squishy-scsi/hardware/README.md

# Squishy - Hardware

This repository contains the hardware design files for [Squishy](https://github.com/squishy-scsi/squishy).

You can view a live rendering of the WIP hardware in your web browser [here](https://kicanvas.org/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), thanks to [KiCanvas](https://kicanvas.org/).

> [!IMPORTANT]
> If you're looking for the Squishy software/gateware, they can be found at [`squishy-scsi/squishy`](https://github.com/squishy-scsi/squishy).

## Documentation

The documentation for the Squishy hardware can be found [here](https://docs.scsi.moe/hardware/index.html).

## License

The hardware design files for Squishy are licensed under the [CERN-OHL-S](https://ohwr.org/cern_ohl_s_v2.txt), the license for which can be found in [LICENSE](./LICENSE)
