squishy-scsi/hardware/contrib/hardware-plans.md

# Squishy - rev2 hardware plan

The following are the planned design requirements for rev2 of the hardware, as well as some wishlist items

## Requirements

- [ ] Allow for both HVD and LVD
- [ ] Single Ended support
- [x] Termpower detection
 - [x] Fix termpower enable, seems to be enabled on powerup,
- [ ] Length-Match the inputs to the SCSI-Phy
- [x] Button for rebooting into bootloader for DFU
- [x] Upgrade FPGA
  - [x] ECP5? - LFE5UM5G-45F-8BG381C
- [ ] >= USB 3.2 Gen1

## Wishlist Items

- [x] USB-C Connector
- [ ] Support for bus arbitration and multi-host bus'

## TODO List:

 - [ ] Removed half of the sys LEDS
 - [ ] Route the ULPI PHY
 - [ ] Route the SuperSpeed lines
 - [ ] Route the SPI Flash
 - [ ] Route the Supervisor connection to the FPGA
 - [ ]

# Squishy - rev3

The following are the planned design requirements for rev3 of the hardware, as well as some wishlist items

## Requirements

## Wishlist Items
