squishy-scsi/hardware/release/rev1/gerbers/squishy-drl_map.dxf

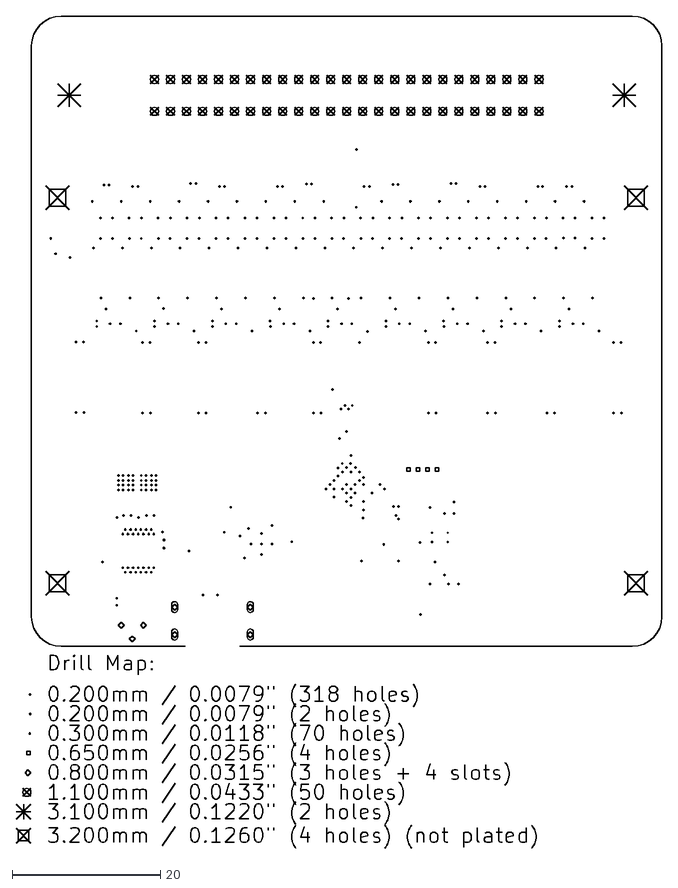
[picture p1: CAD file, 2021-09-27]
release/rev1/gerbers/squishy-drl_map.dxf
87.1 x 112.2
