squishy-scsi/hardware/release/rev2-evt/connector-modules/errata.md

# Squishy rev2-connector-evt Errata

## All

* [ ] Thermal reliefs on all through-hole pins connected to plane layers, especially GND
* [ ] I2C Write-Protect is hard-wired to GND, oops, can't write to any of them,

## HVD-50-CE

## HVD-50-HD

## HVD-50-IDC

## HVD-68-HD

## HVD-68-VHDCI

## MSE-50-CE

## MSE-50-HD

## MSE-50-IDC

## MSE-68-HD

## MSE-68-VHDCI
