squishy-scsi/hardware/boards/squishy/connector-modules/TODO.md

# Connector Modules TODO

- [X] hvd-50-ce
  - [X] Routed
  - [X] Length-Matched
  - [X] ERC
  - [X] DRC
  - [X] CAM Files
  - [X] BOM
- [X] hvd-50-hd
  - [X] Routed
  - [X] Length-Matched
  - [X] ERC
  - [X] DRC
  - [X] CAM Files
  - [X] BOM
- [X] hvd-50-idc
  - [X] Routed
  - [X] Length-Matched
  - [X] ERC
  - [X] DRC
  - [X] CAM Files
  - [X] BOM
- [X] hvd-68-hd
  - [X] Routed
  - [X] Length-Matched
  - [X] ERC
  - [X] DRC
  - [X] CAM Files
  - [X] BOM
- [X] hvd-68-vhdci
  - [X] Routed
  - [X] Length-Matched
  - [X] ERC
  - [X] DRC
  - [X] CAM Files
  - [X] BOM
- [X] mse-50-ce
  - [X] Routed
  - [X] Length-Matched
  - [X] ERC
  - [X] DRC
  - [X] CAM Files
  - [X] BOM
- [X] mse-50-hd
  - [X] Routed
  - [X] Length-Matched
  - [X] ERC
  - [X] DRC
  - [X] CAM Files
  - [X] BOM
- [X] mse-50-idc
  - [X] Routed
  - [X] Length-Matched
  - [X] ERC
  - [X] DRC
  - [X] CAM Files
  - [X] BOM
- [X] mse-68-hd
  - [X] Routed
  - [X] Length-Matched
  - [X] ERC
  - [X] DRC
  - [X] CAM Files
  - [X] BOM
- [X] mse-68-vhdci
  - [X] Routed
  - [X] Length-Matched
  - [X] ERC
  - [X] DRC
  - [X] CAM Files
  - [X] BOM
