squishy-scsi/hardware/(threads)

Thread 13 (2022-06-28):

Complete rev2 FPGA Supervisor layout

lethalbit, 2022-06-28:
The layout for the FPGA supervisor mcu needs to be completed.

- [x] Connect SPI bus + control signals to FPGA
- [x] Connect SPI bus to onboard flash
- [x] Connect LEDs
- [x] Connect to DFU trigger button

Closed 2024-06-14.

Thread 2 (2022-06-28):

micro SD Card SPI/SDIO Support

lethalbit, 2022-06-28:
The rev2 hardware has an on-board micro SD Card slot for storage emulation or other possible features, ideally the communication would be over SDIO if possible, but fallback to SPI mode for the SD Card might be needed.

Closed 2024-06-14.

Thread 6 (2022-06-28):

Layout rev2 tempwr ADC and switching

lethalbit, 2022-06-28:
The rev2 hardware has a current/voltage ADC to measure TERMPWR to try to detect if the hardware has a fault.

This ADC as well as the TERMPWR enable/disable circuitry needs to be laid out and hooked up.

Closed 2024-06-14.

Thread 7 (2022-06-28):

Route the rev2 external trigger and refclk

lethalbit, 2022-06-28:
The rev2 hardware has support for an external trigger and refclk to assist in the analysis and capture of SCSI traffic.

The two SMA connectors on the left edge of the rev2 board need to be routed and length matched.

lethalbit, 2024-06-14:
External Trigger has been done, refclock has not been implemented, maybe on rev3

Closed 2024-06-14.

Thread 9 (2022-06-28):

Design rev2 Physical bus interfaces

lethalbit, 2022-06-28:
The rev2 hardware is designed to have an interchangable bus / device front-end based on using the Samtec QTH-060-01-X-D-RA-PGP as it's connector.

Ideally we will have a board for each of the following SCSI connectors, more than one per board is okay, in the case of the IDC connectors and other small connectors.

- [ ] HD50
- [ ] DB25
- [ ] HD68
- [ ] C50
- [ ] IDC50
- [ ] IDC68
- [ ] SCA80
- [ ] VHDCI
- [ ] MD50
- [ ] MD68

Thread 16 (2024-12-01):

BOM Line consolidation / DFM Optimization

lethalbit, 2024-12-01:
Currently for rev2, and it's supporting boards there is a bit of a chunky BOM, and while some items are shared between the connector boards, the PHYs and the main board, it could be improved.

The following things could vastly simplify the BOM at the cost of ease of assembly:

* [ ] Standardize to smallest package size where possible
  * This would mean that all passives would be `0201` or `0402` where possible
* [ ] Normalize derating for capacitors
  * The capacitors on the board have been derated by at least 150%, which might be overkill but results in larger packages, which also leads into the first item

Those are the first two things that come to mind, there are also some DFM optimizations that would need to be made to make assembly easier, that ties into the BOM consolidation, but there are some other things as well:

* [ ] Remove as many THT parts as possible to remove as much manual assembly as possible
  * Currently there are only 2(?) parts that are through hole, the DC jack and the rest button, we could possibly swap the reset button to an SMD variant and normalize it with the DFU trigger button, which also eliminates a BOM line item.
* [ ] Ensure all ground connections for through-hole parts have thermal spokes
  * Due to the main board being 8-layers and having very substantial ground planes, trying to solder any leads that are connected to ground just soak up heat making it hard to solder.

The following other misc items are also tied in but don't fall exactly in line with DFM, if we want to have a case, it would be cheaper to go for a standard extruded aluminum shell, but this limits our ability to do module stacking like planned, meaning you need to pull the device out of the case to swap things like PHYs or connectors, which is a big downside, but on the upside it would mean you don't need custom milled cases for each part.

We could also possibly squish the board a big to make it less long, compress the power supply area a bit to save board space.

Also possibly rotating the design a bit to have a more standard flow-through so the USB and power connectors are on the bottom rather than side, we would also need to rotate the FPGA anyway if we keep using the ECP5 so we can use the high-speed IO on the SCSI PHY connector.

Thoughts/additions @dragonmux, @esden?

Thread 17 (2025-01-23):

Supervisor/FPGA/PSRAM SPI bus CIPO line loading is environmentally/climate dependant

lethalbit, 2025-01-23:
The `FPGA_CIPO` line from the SPI bus that is between the FPGA, Supervisor, and PSRAM, seems to not be loaded enough in warm and dry conditions.

Probing the bus for debug, or briefly touching a x10 oscilloscope probe to the test point resolves this by adding just a handful of pF enough to cause the bus to come back.

This is only a problem when trying to talk to the PSRAM under a memory read condition before the FPGA is up, if you only read the ID, then it's fine.

This also for some reason does not affect programing the FPGA over the same bus, unsure why.
