squishy-scsi/hardware/release/rev1/squishy.pdf

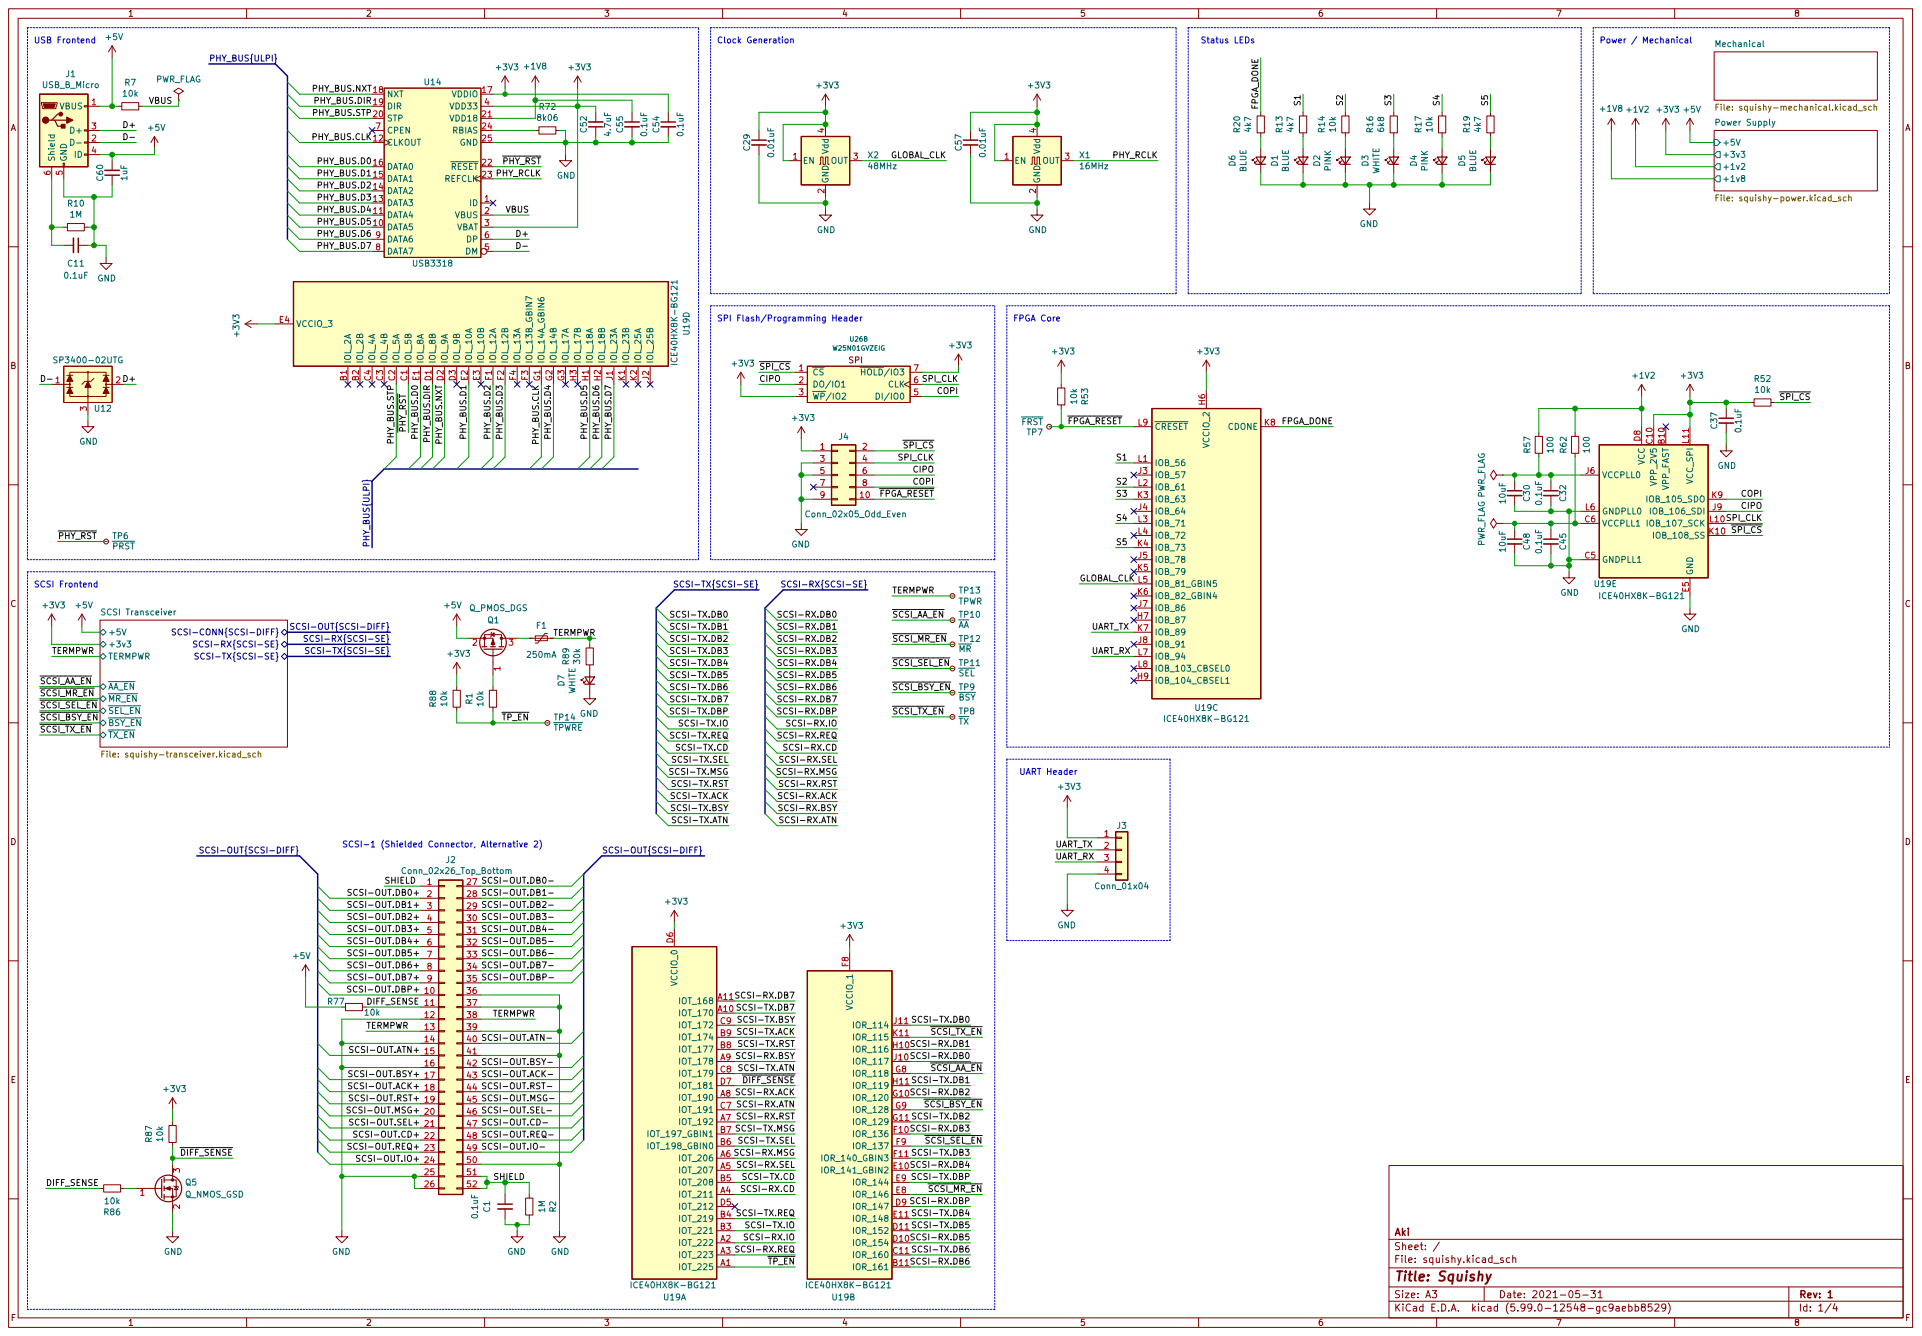
[picture p2: page 1]

FPGA Core USB Frontend

Power / Mechanical SCSI Frontend

Mechanical File: squishy-mechanical.kicad_sch +5V

SCSI-RX.ATN PHY_BUS.D7 TERMPWR

SCSI-RX{SCSI-SE}

SCSI-TX.DB4 SCSI-TX.DB1 SCSI-TX{SCSI-SE} SCSI-TX.DB0 SCSI-OUT.REQ+

TERMPWR
SCSI-RX.DB7 SCSI-RX.DB5 SCSI-RX.BSY
SCSI-RX.RST SCSI-RX.DB7 SCSI-TX.SEL ~{TP_EN}

~{TP_EN} SCSI-OUT.DBP- TERMPWR

SCSI-CONN{SCSI-DIFF} TERMPWR

SCSI-TX{SCSI-SE}

SCSI-TX.DB7
SCSI-TX.DB1 SCSI-TX.DBP
SCSI-TX.IO
SCSI-TX.REQ

SCSI-RX.DBP
SCSI-RX.IO
SCSI-RX.REQ
SCSI-RX.CD
SCSI-RX.SEL SCSI-RX.ACK
SCSI-RX.MSG

SCSI-1 (Shielded Connector, Alternative 2)

SCSI-OUT.DB1- SCSI-OUT.SEL+ SHIELD

SCSI-RX.DB4 ~{SCSI_MR_EN} SCSI-TX.BSY
~{DIFF_SENSE} SCSI-TX.ACK
SCSI-TX.RST

SCSI-RX.RST SCSI-RX.MSG
SCSI-TX.MSG

SCSI-TX.DB4 SCSI-TX.DBP

File: squishy.kicad_sch Sheet: / Aki

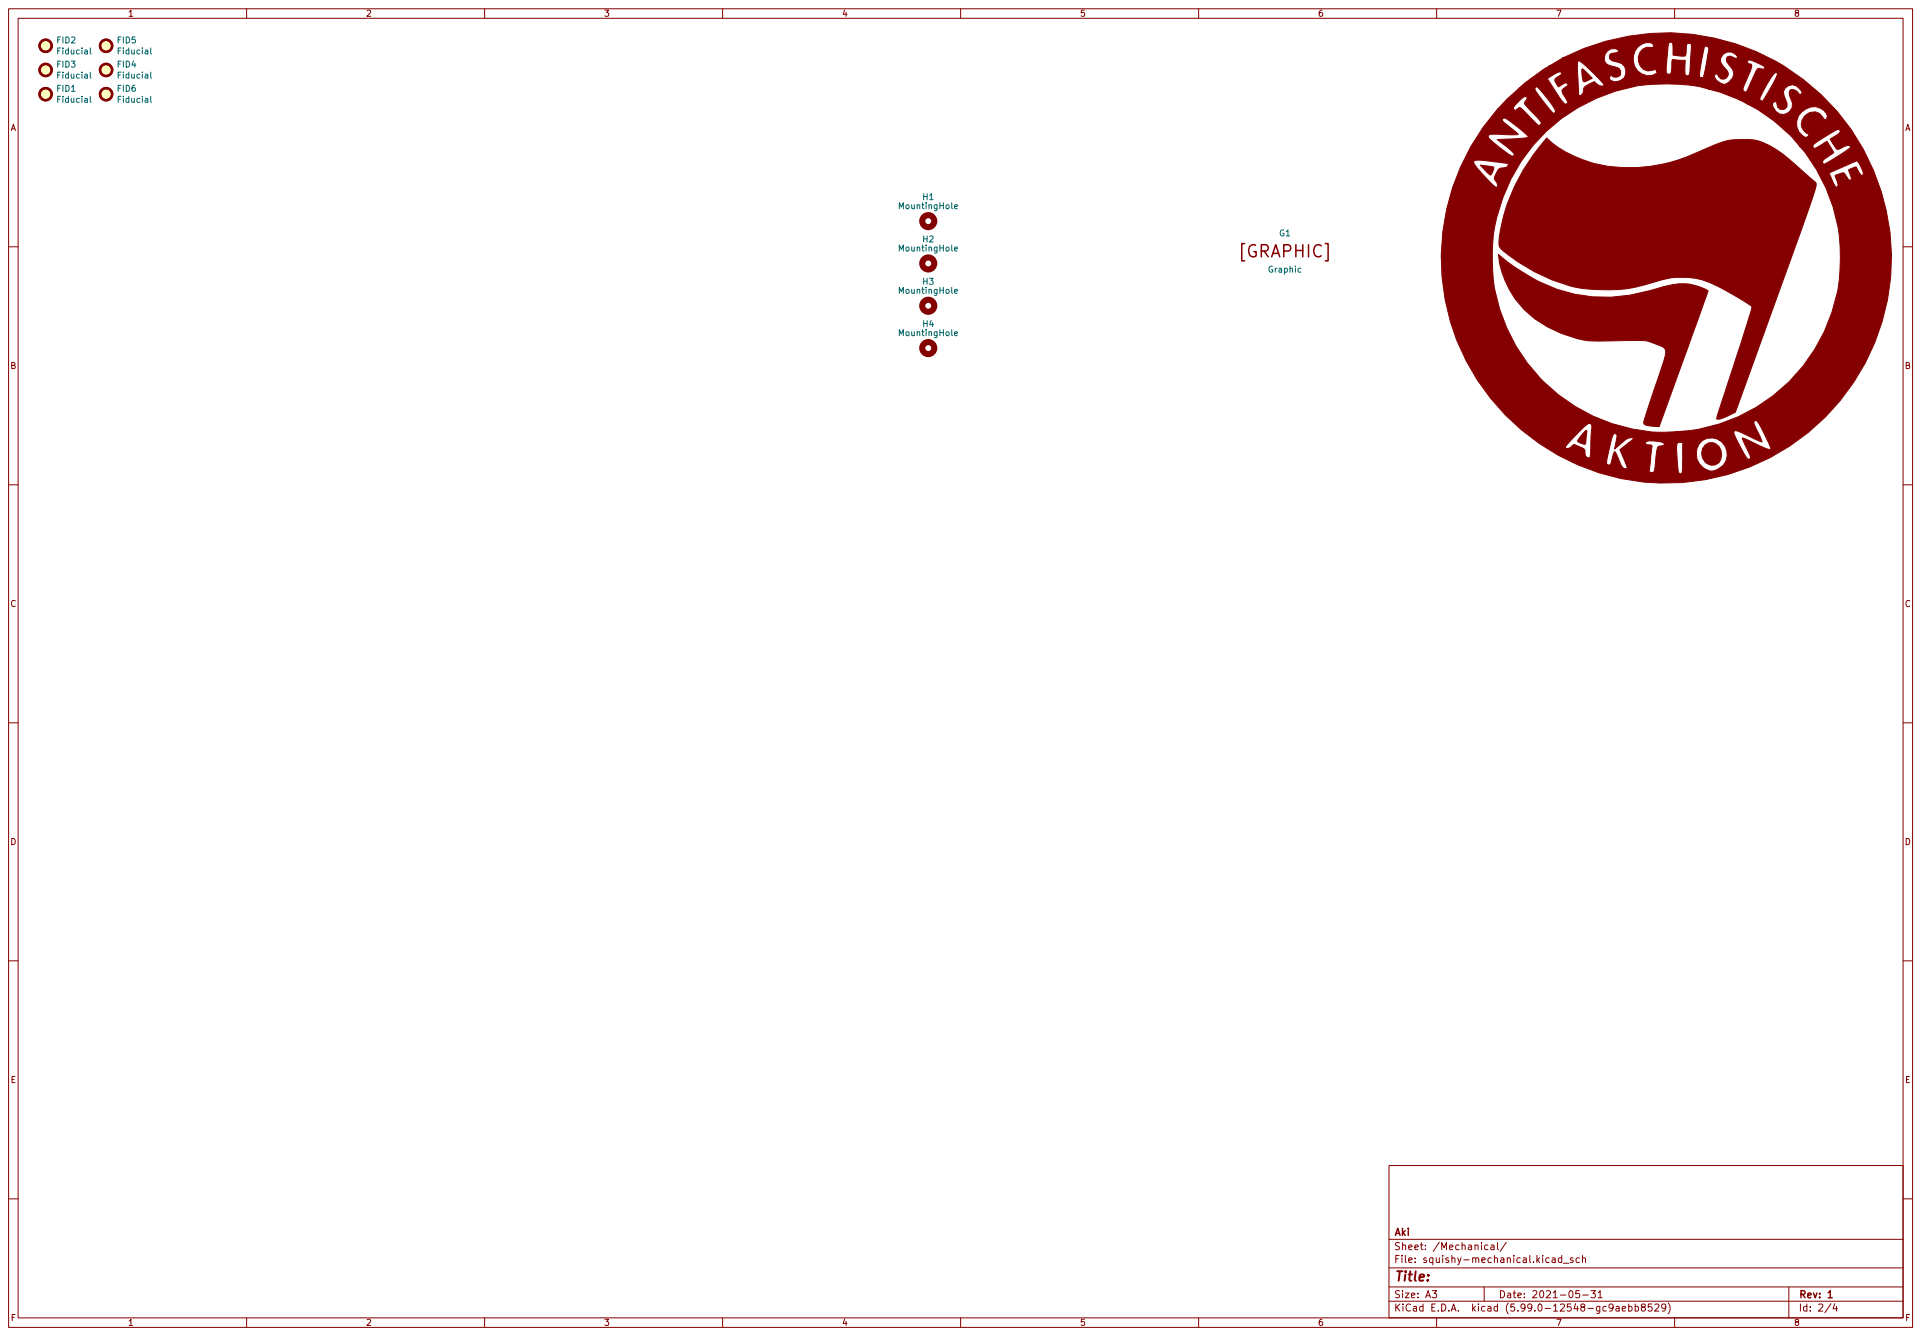
[picture p3: page 2]

[GRAPHIC] G1 Graphic H4 MountingHole H1 MountingHole H2 MountingHole

File: squishy-mechanical.kicad_sch Sheet: /Mechanical/ Aki

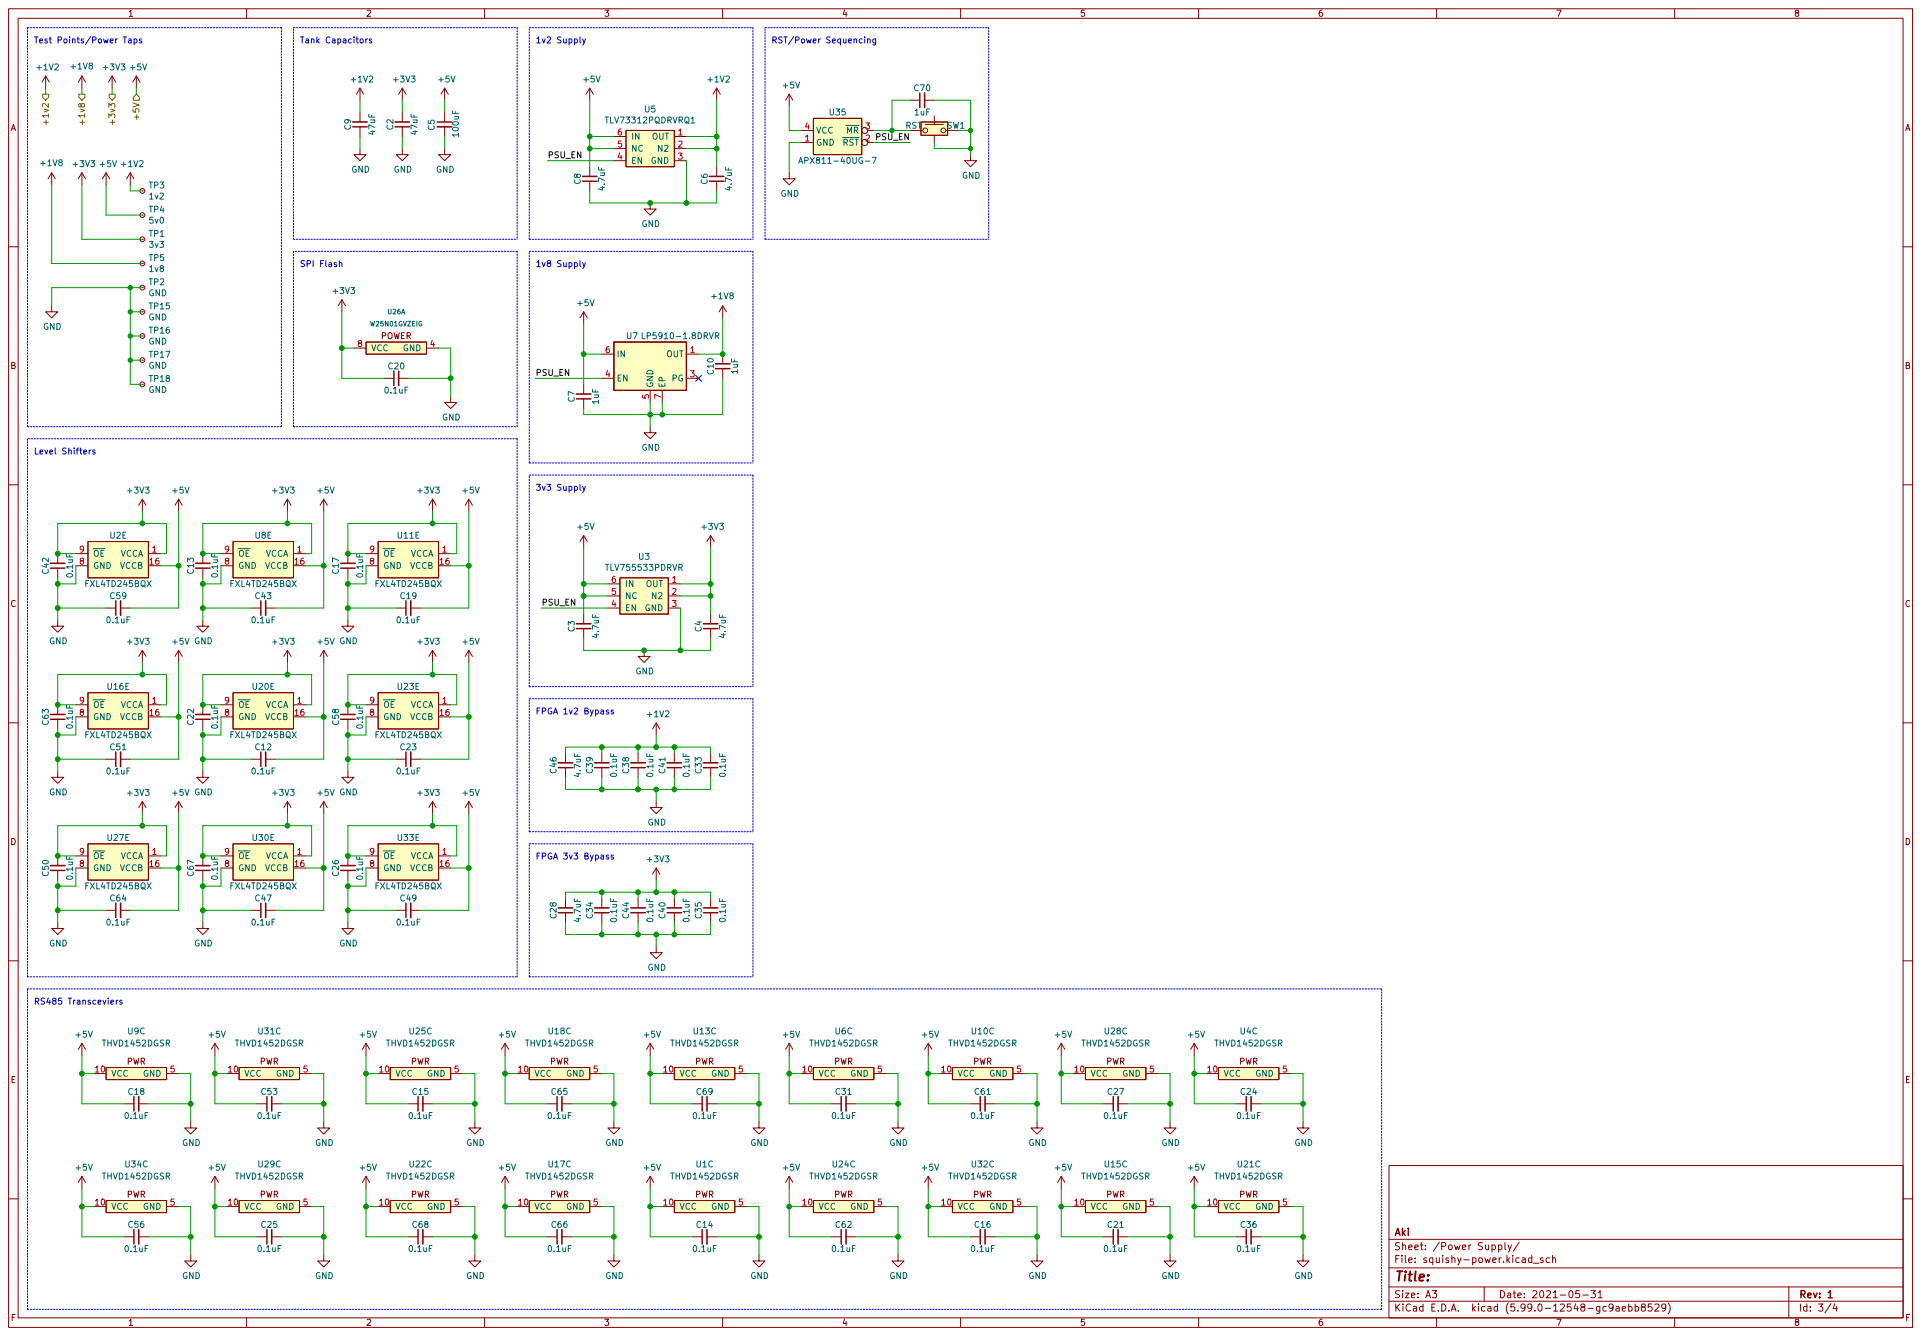
[picture p4: page 3]

Test Points/Power Taps

Sheet: /Power Supply/ Aki

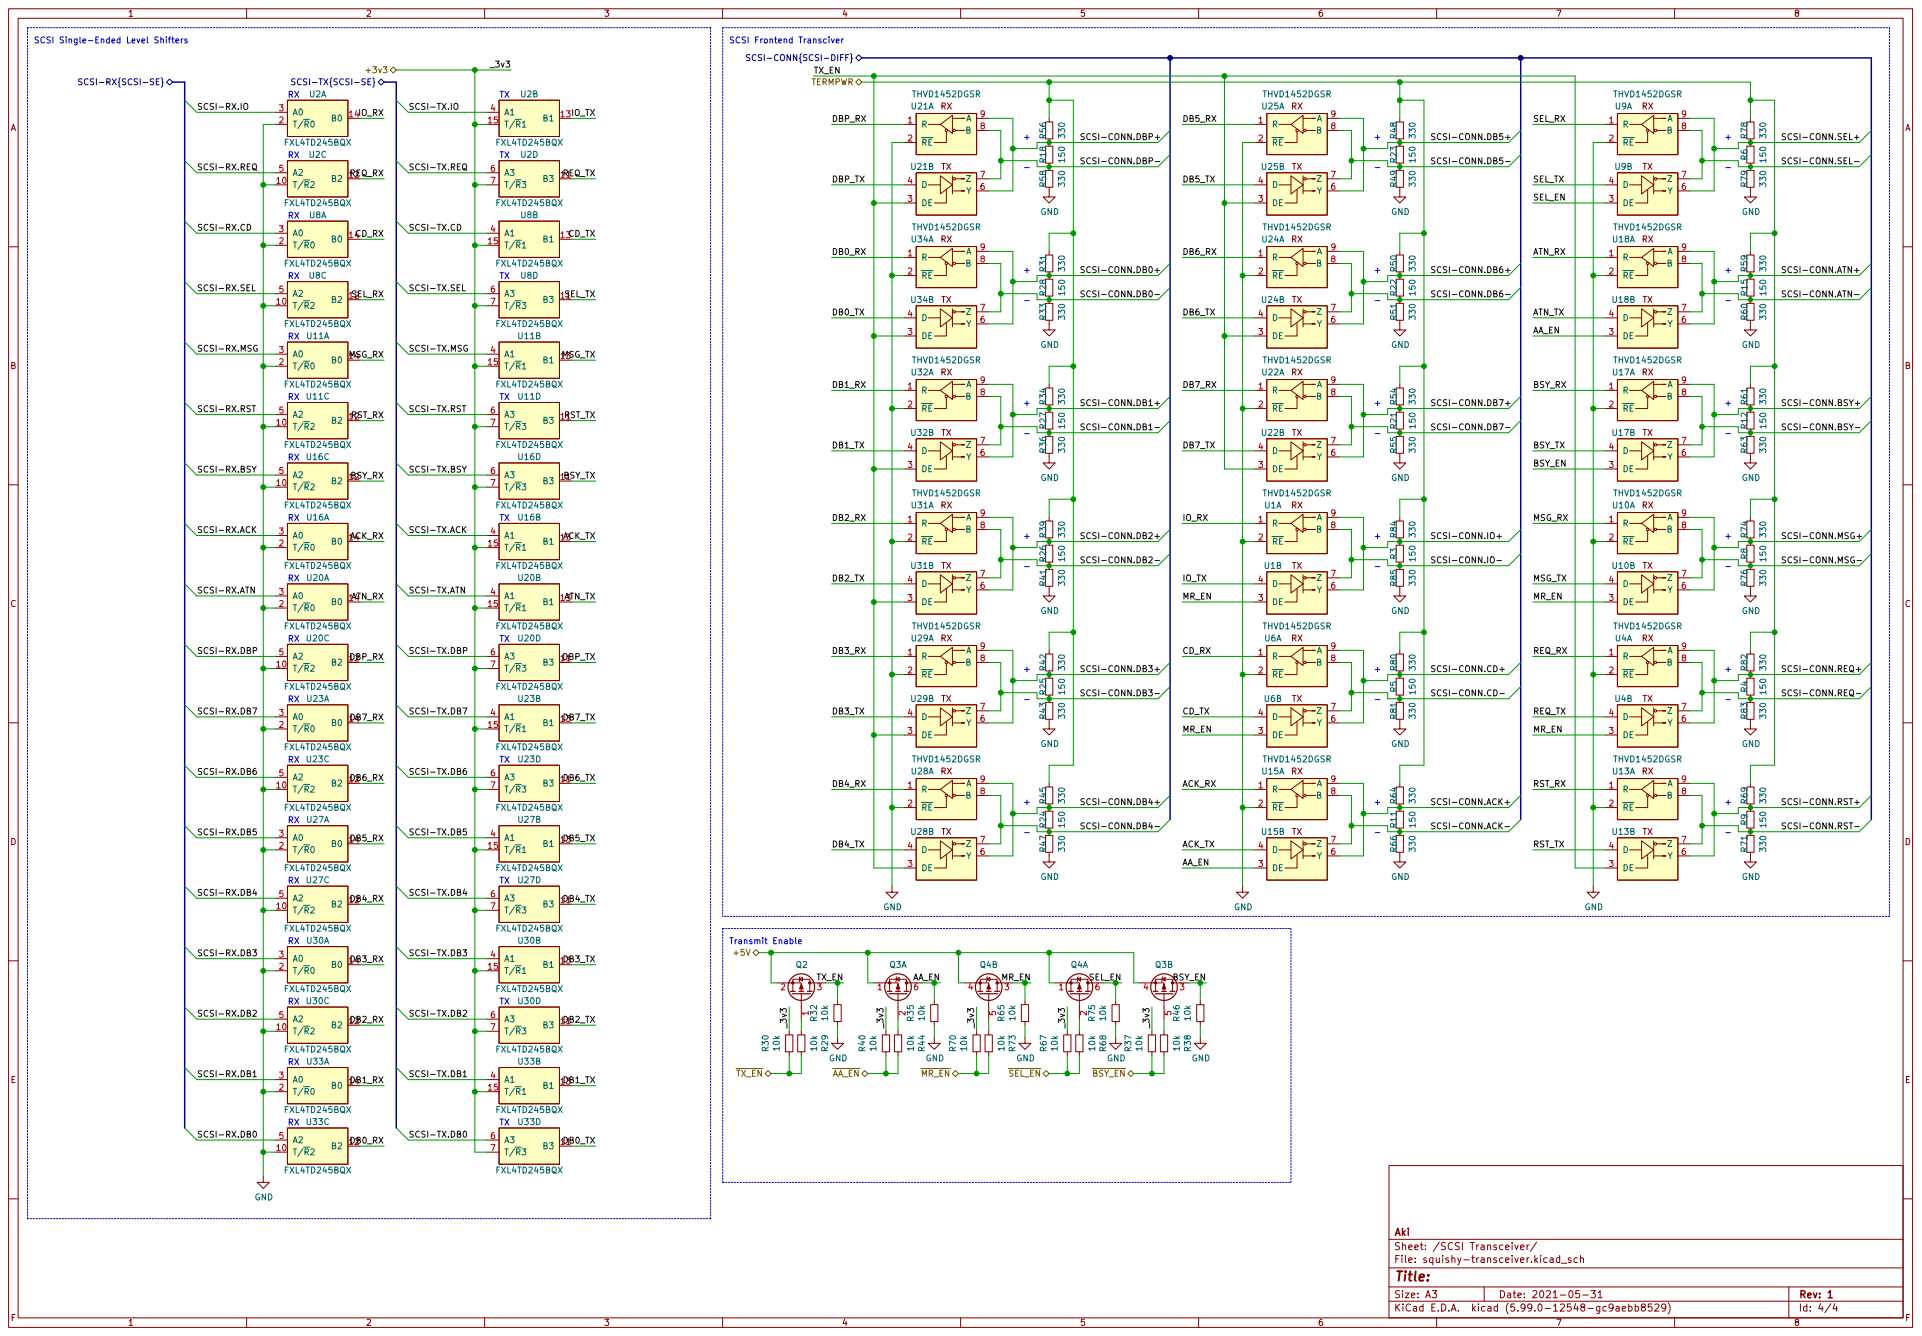
[picture p5: page 4]

SCSI-CONN{SCSI-DIFF} TERMPWR

SCSI-CONN.DBP- SCSI-CONN.DBP+ SEL_TX MSG_TX RST_TX

SCSI-TX.SEL SCSI-TX.CD

SCSI-CONN.REQ- SCSI-CONN.ACK-

File: squishy-transceiver.kicad_sch Sheet: /SCSI Transceiver/ Aki
