squishy-scsi/hardware/(commit log)

2020-07-11 Added the kicad projects
    [squishy.kicad_pcb, squishy.sch]
2020-07-11 Completed the layout for the faux SCSI tranciver
    [squishy.kicad_pcb]
2020-07-22 Updates, moved to an FTDI chip
    [squishy.kicad_pcb, squishy.sch]
2020-07-25 Routed the rest of the buses for the level shifters, added the bypass caps, and a whole bunch of other stuff
    [squishy.kicad_pcb, squishy.sch]
2020-07-25 Completed the routing and power, the last two things to do are sort the SCSI TERMPOWER and DIFFSENSE, and then the FPGA reset.
    [squishy.kicad_pcb, squishy.sch]
2020-07-26 Added the needed bits for TERMPOWER and for the DIFFSENS line
    [squishy.kicad_pcb, squishy.sch]
2020-07-26 Skew-matched most of the diff-pairs
    [squishy.kicad_pcb]
2020-08-02 Updates to the schematic, REV0 is "done"
    [squishy.kicad_pcb, squishy.sch]
2020-08-02 Added the generated gerbers and the rendered schematic
    [squishy-B_Cu.gbl, squishy-B_Mask.gbs, squishy-B_Paste.gbp, squishy-B_SilkS.gbo, squishy-Edge_Cuts.gm1, squishy-F_Cu.gtl, squishy-F_Mask.gts, squishy-F_Paste.gtp]
2020-08-02 Fixed some part attributes
    [squishy.sch]
2020-08-02 Added rev0 BOM
    [squishy-bom.csv]
2021-05-31 Moved some things around and cached the rev0 of squishy
    [squishy.kicad_pcb, squishy.kicad_sch, squishy.sch]
2021-06-16 hardware: massive board overhaul for rev1
    [squishy-mechanical.kicad_sch, squishy-power.kicad_sch, squishy-transceiver.kicad_sch, squishy.kicad_sch, squishy.sch]
2021-06-16 gateware/docs: removed the empty TODO file and also re-organized the gateware a bit
    [squishy.kicad_sch]
2021-06-20 hardware: Updated flash footprint so the solder paste isn't a giant glob
2021-06-24 Updated the silkscreen
    [squishy-mechanical.kicad_sch, squishy-power.kicad_sch, squishy-transceiver.kicad_sch, squishy.kicad_sch]
2021-06-25 Added a UART for debugging
    [squishy.kicad_sch]
2021-07-04 Fixed the SCSI connector shield ground points for bolts
2021-08-24 hardware: shuffled some pins around to make the ulpi traces nicer
    [squishy.kicad_sch]
2021-09-07 hardware: something updated but i don't know what it was
    [squishy.kicad_sch]
2021-09-25 hardware: gutted rev0, as the hardware was fundamentally flawed and non-functional
    [squishy-B_Cu.gbl, squishy-B_Mask.gbs, squishy-B_Paste.gbp, squishy-B_SilkS.gbo, squishy-Edge_Cuts.gm1, squishy-F_Cu.gtl, squishy-F_Mask.gts, squishy-F_Paste.gtp]
2021-09-25 hardware: some more minor pcb edits
2021-09-26 hardware: added some additional test points
    [squishy.kicad_sch]
2021-09-26 hardware: fixed a blip in the scsi wiggles, added ESD protection to the USB line because i got bullied into doing so
    [squishy.kicad_sch]
2021-09-26 hardware: a bunch of clean up and the like
    [squishy-mechanical.kicad_sch, squishy-power.kicad_sch, squishy-transceiver.kicad_sch, squishy.kicad_sch]
2021-09-26 hardware: ensured we got a clean bill of health from DRC and ERC
    [squishy-power.kicad_sch, squishy-transceiver.kicad_sch, squishy.kicad_sch]
2021-09-26 hardware: fixed up some datasheets for symbols and added mounting holes
    [squishy-mechanical.kicad_sch, squishy-power.kicad_sch, squishy-transceiver.kicad_sch, squishy.kicad_sch]
2021-09-26 hardware: found an error with how the SCSI connector was laid out, fixed that, oh no, my poor pcb
    [squishy.kicad_sch]
2021-09-26 hardware: ensured all of the parts had a mpn and mfr
    [squishy-mechanical.kicad_sch, squishy-power.kicad_sch, squishy.kicad_sch]
2021-09-26 hardware: added reset gen for power sequencing
    [squishy-power.kicad_sch, squishy.kicad_sch]
2021-09-26 hardware: added additional ground points
    [squishy-power.kicad_sch, squishy.kicad_sch]
2021-09-26 hardware: went-through the schematic checklist and ensured it was correct and complete, hence the previous few commits
2021-09-26 hardware: fipped the reset button pins around to make more sense and placed the reset button
    [squishy-power.kicad_sch]
2021-09-26 hardware: added more ground test points
2021-09-26 hardware: hooked up the power supply sequencing and reset button
2021-09-26 hardware: supposedly fixed the pin ordering for all the scsi stuff, i hope
    [squishy-transceiver.kicad_sch, squishy.kicad_sch]
2021-09-26 hardware: termination resistors kicked my ass, but most of the nets are correct now
    [squishy-transceiver.kicad_sch]
2021-09-26 hardware: fixed up the bsy/ack as they were mixed up, still need to fix the enable signals
    [squishy-transceiver.kicad_sch]
2021-09-26 hardware: some more cleanup of silkscreen and the like
2021-09-26 hardware: ensured clean erc and drc again, updated the scsi connector w/ a 3d model
2021-09-27 hardware: fixed up the gnd plane below the fpga
    [squishy.kicad_sch]
2021-09-27 hardware: fixed the wson footprint for the chonky flash
2021-09-27 hardware: cleaned up the SPI flash a lot and moved the FPGA status led
2021-09-27 hardware: added termpower indicator and pullup so we don't accidentally enable termpower on boot
    [squishy.kicad_sch]
2021-09-27 hardware: final cleanups and settings in prep for gerber generation
2021-09-27 hardware: added the "official" rev1 hardware output used to fab the boards
    [squishy-B_Cu.gbl, squishy-B_Mask.gbs, squishy-B_Paste.gbp, squishy-B_Silkscreen.gbo, squishy-Edge_Cuts.gm1, squishy-F_Cu.gtl, squishy-F_Mask.gts, squishy-F_Paste.gtp]
2021-09-27 hardware: rev1 fixed an oopsie with the colours and the exported schematic
2021-09-28 hardware: started on a list of some initial improvements for rev2, more will be added once the rev1 hardware is assembled and tested
2021-09-28 hardware: added kicad project bits for rev1 do it's directory
    [squishy-mechanical.kicad_sch, squishy-power.kicad_sch, squishy-transceiver.kicad_sch, squishy.kicad_sch, squishy.sch]
2021-09-28 hardware: cleaned up the squishy kicad project dir
    [squishy.sch]
2021-09-28 hardware: upadated the 3d model for the switch
2021-09-29 hardware: added keep file for case dir for the rev1 board
2021-10-02 hardware: moved the squishy files into a subdir in the boards directory
    [squishy-mechanical.kicad_sch, squishy-power.kicad_sch, squishy-transceiver.kicad_sch, squishy.kicad_sch]
2021-10-02 hardware: added rev1 BOM
    [squishy-rev1-bom.csv]
2021-10-02 hardware: updated the rev1 board file cache
2021-10-03 hardware: started on the pass inline scsi tap
    [scsi-50-tap.kicad_pcb, scsi-50-tap.kicad_sch]
2021-10-03 hardware: cleanup and revamp for squishy rev2
    [squishy-mechanical.kicad_sch, squishy-power.kicad_sch, squishy-transceiver.kicad_sch, squishy.kicad_sch]
2021-10-03 hardware: lots of work on the initial layout of rev2, not gonnya but too much effort in now though until we find all the problems with rev1
    [squishy-mechanical.kicad_sch, squishy-power.kicad_sch, squishy.kicad_sch]
2021-10-04 hardware: large chunk of work on the initial stages of rev2
    [squishy-power.kicad_sch, squishy.kicad_pcb, squishy.kicad_sch]
2021-10-04 hardware: some more work on rev2 getting the psu and the like sorted
    [squishy-power.kicad_sch, squishy.kicad_pcb, squishy.kicad_sch]
2021-10-12 hardware: fixed the part number for the FPGA
    [squishy-power.kicad_sch, squishy.kicad_sch]
2021-10-15 hardware: added some more design notes from results found from rev1 assembly
2021-10-17 hardware: added a note if we should allow powering from termpwr if emulating a device
2021-10-18 hardware: got most of everything but the scsi phy done, that still needs to be designed
    [squishy-power.kicad_sch, squishy-termpwr.kicad_sch, squishy.kicad_pcb, squishy.kicad_sch]
2021-10-18 hardware: added external trigger and refclock connectors
    [squishy-mechanical.kicad_sch, squishy-power.kicad_sch, squishy-termpwr.kicad_sch, squishy.kicad_pcb, squishy.kicad_sch]
2021-10-18 hardware: did a lot of routing, added a syzygy connector for daughter cards
    [squishy-termpwr.kicad_sch, squishy.kicad_sch]
2021-10-21 hardware: some silkscreen adjustments
    [squishy-mechanical.kicad_sch, squishy-termpwr.kicad_sch, squishy-transceiver.kicad_sch, squishy.kicad_sch]
2021-10-22 hardware: in the process of swapping out the hard-mount scsi connector for a mezzanine connector to allow for swapping out of connectors
    [squishy-transceiver.kicad_sch, squishy.kicad_sch]
2021-11-01 hardware: some cleanup of the schematics, also added a dedicated uart port for the FPGA, and test points for SWD
    [squishy-transceiver.kicad_sch, squishy.kicad_sch]
2021-11-01 hardware: did a whole lot of work on changing the form factor of the board as well as finally assigning the signals and some initial routing.
    [squishy-mechanical.kicad_sch, squishy-termpwr.kicad_sch, squishy.kicad_sch]
2021-11-06 hardware: updated kicad-nightly and refreshed project files
    [squishy-mechanical.kicad_sch, squishy-power.kicad_sch, squishy-termpwr.kicad_sch, squishy.kicad_sch]
2021-11-24 hardware: some small updated on the rev2 board, getting ready to design the universal scsi transceiver
2021-11-26 hardware: some minor tweaks
    [squishy-mechanical.kicad_sch, squishy-power.kicad_sch, squishy-termpwr.kicad_sch, squishy.kicad_sch]
2021-12-05 hardware: updated KiCad to v6 and replaced the silly USB-C connector with something more sane for USB 2
    [squishy-mechanical.kicad_sch, squishy-power.kicad_sch, squishy-termpwr.kicad_sch, squishy.kicad_sch]
2021-12-19 hardware: scsi-tap: 50: Updated the 50-pin scsi tap, still needs some work
    [scsi-50-tap.kicad_pcb, scsi-50-tap.kicad_sch]
2021-12-21 hardware: some updates to the connector being used for rev2 and it's modular bits
    [squishy-phy.kicad_sch, squishy-power.kicad_sch, squishy.kicad_sch]
2021-12-21 hardware: cleaned up the schematics a bit and made them more unified
    [squishy-mechanical.kicad_sch, squishy-phy.kicad_sch, squishy-power.kicad_sch, squishy-termpwr.kicad_sch, squishy.kicad_sch]
2021-12-21 hardware: fixed up the hardware a bit and resized the board
2021-12-21 hardware: fixed the large connector symbol pinout
    [squishy.kicad_sch]
2022-01-06 hardware: updated to KiCad 6.0 stable
2022-01-08 hardware: removed the syszygy connector
    [squishy-power.kicad_sch, squishy-termpwr.kicad_sch, squishy.kicad_sch]
2022-01-08 hardware: updated footprints for kicad 6
    [squishy.kicad_pcb]
2022-01-08 hardware: update fuse symbol footprint
    [squishy-termpwr.kicad_sch, squishy.kicad_pcb, squishy.kicad_sch]
2022-01-08 hardware: some ERC cleanup
    [squishy-phy.kicad_sch, squishy-power.kicad_sch, squishy-termpwr.kicad_sch, squishy.kicad_pcb, squishy.kicad_sch]
2022-01-13 hardware: updated hardware plans, moving from the LEF5U-*F-8BG256C to the LEF5UM5G-*F-8BG381C to allow for USB 3.1 gen 1
    [squishy.kicad_sch]
2022-01-13 hardware: started gutting the old FPGA in preparation to migrate to the new FPGA
    [squishy-phy.kicad_sch, squishy-power.kicad_sch, squishy-termpwr.kicad_sch, squishy.kicad_sch]
2022-01-14 hardware: started the absolutely colossal rework/refactor that is switching FPGAs and moving from USB2 to USB 3.2 Gen 1x1
    [squishy-mechanical.kicad_sch, squishy-phy.kicad_sch, squishy-power.kicad_sch, squishy-termpwr.kicad_sch, squishy-usbfe.kicad_sch, squishy.kicad_sch]
2022-01-14 hardware: sorted out some of the FPGA banks so they're in their proper home
    [squishy-power.kicad_sch, squishy-usbfe.kicad_sch, squishy.kicad_sch]
2022-01-16 hardware: large amount of refactoring and schematic tetris, slowly getting everything hooked back up, also merrged all the DFU/Debug signals onto a single connector
    [squishy-mechanical.kicad_sch, squishy-power.kicad_sch, squishy-usbfe.kicad_sch, squishy.kicad_sch]
2022-01-16 hardware: some more refactoring, prior to a full PCB rip-up and re-layout
    [squishy-power.kicad_sch, squishy.kicad_sch]
2022-01-19 hardware: added back the 1v8 regulated as we need the ULPI PHY again for USB2 compatibility, also updated the sheet metadata
    [squishy-mechanical.kicad_sch, squishy-phy.kicad_sch, squishy-power.kicad_sch, squishy-termpwr.kicad_sch, squishy-transceiver.kicad_sch, squishy-usbfe.kicad_sch, squishy.kicad_sch]
2022-01-22 hardware: squishy: some poking around, don't quite recall what was done
    [squishy.kicad_pcb]
2022-01-24 hardware: squishy: got most of the USB FE done, it's a bit of a squiggly mess but should work:tm:
    [squishy-usbfe.kicad_sch, squishy.kicad_pcb]
2022-01-24 hardware: squishy: some more minor work on the USB FE
    [squishy-power.kicad_sch, squishy-usbfe.kicad_sch, squishy.kicad_pcb, squishy.kicad_sch]
2022-01-24 hardware: squishy: rev1: updated KiCad files to latest version
    [squishy.kicad_sch]
2022-01-24 hardware: squishy: added the vbus resistor for the ULPI PHY
    [squishy-usbfe.kicad_sch, squishy.kicad_pcb, squishy.kicad_sch]
2022-01-24 hardware: squishy: some more minor usb-fe updates
    [squishy-usbfe.kicad_sch, squishy.kicad_sch]
2022-02-14 hardware: squishy: picking back up on things, don't recall what was updated last
    [squishy-usbfe.kicad_sch, squishy.kicad_pcb, squishy.kicad_sch]
2022-02-14 hardware: squishy: updated the debug/programming connector and added the proper footprint
    [squishy.kicad_pcb, squishy.kicad_sch]
2022-02-14 hardware: squishy: cleaned up some testpoints and made sure things that should not be in the BOM are not
    [squishy-power.kicad_sch, squishy.kicad_pcb, squishy.kicad_sch]
2022-02-14 hardware: squishy: cleaned up floating traces and grouped the LEDs and USB-FE, also moved the LEDs to their new home
    [squishy.kicad_pcb]
2022-02-14 hardware: squishy: some more cleanup, as well as starting work on the PSU side of things finally
    [squishy-power.kicad_sch, squishy-usbfe.kicad_sch, squishy.kicad_pcb, squishy.kicad_sch]
2022-02-16 hardware: squishy: replaced the SPI flash with a less batshit device from GigaDevice
    [squishy-power.kicad_sch, squishy-usbfe.kicad_sch, squishy.kicad_pcb, squishy.kicad_sch]
2022-02-16 hardware: squishy: added the microSD card slot
    [squishy.kicad_pcb, squishy.kicad_sch]
2022-02-17 hardware: squishy: some misc additions, mainly a pull-up resistor for the sd card detect and the SPI CS for the FPGA
    [squishy.kicad_pcb, squishy.kicad_sch]
2022-02-17 hardware: squishy: some footprint/part updates and cleanup
    [squishy-usbfe.kicad_sch, squishy.kicad_pcb, squishy.kicad_sch]
2022-02-17 hardware: squishy: some silkscreen updates and cleanup
    [squishy-usbfe.kicad_sch, squishy.kicad_pcb]
2022-02-17 hardware: squishy: usb fe: fixing up and getting the last little bits of the USB front end done and dusted, just needs power routing now
    [squishy-usbfe.kicad_sch, squishy.kicad_pcb]
2022-02-20 hardware: fixed the USB PD controller pinout, as well as the AT SAMD symbol
    [squishy-usbfe.kicad_sch, squishy.kicad_pcb, squishy.kicad_sch]
2022-02-20 hardware: squishy: moved the flow diagram for the USB front-end bring-up
    [squishy-usbfe.kicad_sch]
2022-02-20 hardware: squishy: some minor ERC fixes
    [squishy-usbfe.kicad_sch, squishy.kicad_sch]
2022-02-20 hardware: squishy: added the DC blocking caps to the USB-FE TX lines
    [squishy-usbfe.kicad_sch, squishy.kicad_pcb, squishy.kicad_sch]
2022-02-24 hardware: squishy: some hyperram stuff and library updates
    [squishy-power.kicad_sch, squishy-usbfe.kicad_sch, squishy.kicad_pcb, squishy.kicad_sch]
2022-03-20 hardware: squishy: updated the schematic date and added the HyperRAM to it's own sheet, as well as did a rough hookup of the microSD lines
    [squishy-hyperram.kicad_sch, squishy-phy.kicad_sch, squishy-power.kicad_sch, squishy-termpwr.kicad_sch, squishy-usbfe.kicad_sch, squishy.kicad_pcb, squishy.kicad_sch]
2022-03-24 hardware: squishy: minor updates
    [squishy-hyperram.kicad_sch, squishy.kicad_sch]
2022-06-28 hardware: rev1: Updated the SPI flash and ULPI osc, this closes #2
    [squishy-B_Cu.gbl, squishy-B_Mask.gbs, squishy-B_Paste.gbp, squishy-B_Silkscreen.gbo, squishy-Edge_Cuts.gm1, squishy-F_Cu.gtl, squishy-F_Mask.gts, squishy-F_Paste.gtp]
2022-07-16 hardware: some minor rev2 updates, mainly hyperram
    [squishy-hyperram.kicad_sch, squishy-power.kicad_sch, squishy-usbfe.kicad_sch, squishy.kicad_sch]
2022-08-29 hardware: removed unneeded kicad 5 cache/rescue files
2023-01-10 hardware: some rough pokes on starting to get back on to working on rev2 hardware.
    [squishy-power.kicad_sch, squishy-usbfe.kicad_sch, squishy.kicad_pcb, squishy.kicad_sch]
2023-03-07 hardware: updated to KiCad 7.0
    [scsi-50-tap.kicad_pcb, scsi-50-tap.kicad_sch, squishy-hyperram.kicad_sch, squishy-mechanical.kicad_sch, squishy-phy.kicad_sch, squishy-power.kicad_sch, squishy-termpwr.kicad_sch, squishy-transceiver.kicad_sch]
2023-04-04 hardware: Moved a silly little silkscreen marking that was out in the middle of nowhere
    [squishy-usbfe.kicad_sch, squishy.kicad_pcb, squishy.kicad_sch]
2023-04-30 hardware: Decided on the structure for the PHY and connector sub boards,
    [squishy-usbfe.kicad_sch, squishy.kicad_pcb, squishy.kicad_sch]
2023-04-30 hardware: Updated the LEDs to make room for light pipes, swapped the USB-SS TX and RX polarities, added a 100MHz REFCLK for USB3 and also replaced the part for the 48MHz sysclock
    [squishy-usbfe.kicad_sch, squishy.kicad_pcb, squishy.kicad_sch]
2023-05-14 rev1: Moved rev1 design files into `release/rev1`
    [squishy-B_Cu.gbl, squishy-B_Mask.gbs, squishy-B_Paste.gbp, squishy-B_Silkscreen.gbo, squishy-Edge_Cuts.gm1, squishy-F_Cu.gtl, squishy-F_Mask.gts, squishy-F_Paste.gtp]
2023-05-21 started re-organizing repo layout for new hardware structure
    [squishy-hyperram.kicad_sch, squishy-phy.kicad_sch, squishy-power.kicad_sch, squishy-termpwr.kicad_sch, squishy-usbfe.kicad_sch, squishy.kicad_pcb, squishy.kicad_sch]
2023-06-01 contrib: Added some very preliminary notes on the board-to-board connections
2023-06-01 contrib: added the extra design rules for Squishy boards
2023-06-01 boards: main: Removed the old main boards, added new empty project
    [squishy-hyperram.kicad_sch, squishy-main.kicad_pcb, squishy-main.kicad_sch, squishy-phy.kicad_sch, squishy-power.kicad_sch, squishy-termpwr.kicad_sch, squishy-usbfe.kicad_sch, squishy.kicad_pcb]
2023-06-04 rev2: main: Started mushing things back together for the main board, also switched the system clock from 48MHz CMOS to 100MHz LVDS and stuffed it into the GPLL0 pins for internal clocking up for the 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
    [squishy-main-power.kicad_sch, squishy-main-usbfe.kicad_sch, squishy-main.kicad_sch]
2023-06-11 boards: main: some minor updates
    [squishy-main.kicad_sch]
2023-08-08 squishy: main: updated the board stackup and went from 6 to 8 layers
    [squishy-main.kicad_pcb]
2023-08-08 git: Added `kicad_sch-bak` to the git ignore
2023-08-08 squishy: main: some minor misc schematic updates
    [squishy-main-power.kicad_sch, squishy-main-usbfe.kicad_sch, squishy-main.kicad_sch]
2023-08-11 squishy: main: started working on the new SEPIC supply
    [squishy-main-power.kicad_sch, squishy-main-usbfe.kicad_sch, squishy-main.kicad_sch]
2023-08-11 squishy: main: updated the hyperRAM to use the new cursed topology
    [squishy-main.kicad_sch]
2023-08-21 updated gitignore to ignore KiCad lock files
2023-08-21 squishy: main: added some indicator LEDs and some series resistors on the clock lines to prevent sharp edges
    [squishy-main-usbfe.kicad_sch, squishy-main.kicad_sch]
2023-08-21 squishy: main: started on some /really rough/ SEPIC supply stuff
    [squishy-main-power.kicad_sch]
2023-08-21 squishy: main: misc cleanup and formatting fixes
    [squishy-main-power.kicad_sch, squishy-main-usbfe.kicad_sch, squishy-main.kicad_sch]
2023-10-01 squishy: main: A /huge/ cleanup and some progress on the PSU side, finally, still a lot to do
    [squishy-main-power.kicad_sch, squishy-main-usbfe.kicad_sch, squishy-main.kicad_sch]
2023-10-01 squishy: main: updated the schematic frames
    [squishy-main-power.kicad_sch, squishy-main-usbfe.kicad_sch, squishy-main.kicad_sch]
2023-10-01 squishy: main: another batch of misc cleanups and tidying
    [squishy-main-power.kicad_sch, squishy-main-usbfe.kicad_sch, squishy-main.kicad_sch]
2023-10-06 boards: main: large re-work of the power situation and also cleanup from library updates
    [squishy-main-power.kicad_sch, squishy-main-usbfe.kicad_sch, squishy-main.kicad_sch]
2024-02-11 squishy: main: More massive rework of the power situation, now with OVP and OCP, as well as if needed supplemental DC jack if USB-PD is not available
    [squishy-main-power.kicad_sch]
2024-02-11 squishy: main: Replaced the PD controller with a simpler one
    [squishy-main-usbfe.kicad_sch]
2024-02-11 squishy: main: handful of misc updates all jumbled together
    [squishy-main.kicad_pcb, squishy-main.kicad_sch]
2024-02-11 squishy: main: Added a whole bunch of test points
    [squishy-main-power.kicad_sch, squishy-main-usbfe.kicad_sch, squishy-main.kicad_pcb, squishy-main.kicad_sch]
2024-02-19 squishy: main: Fixed ERC errors on the `VBUS`/`VDC` and `VCC` nets due to the brain scramble that is the new power topology
    [squishy-main-power.kicad_sch, squishy-main-usbfe.kicad_sch]
2024-02-19 squishy: main: some initial poking at SCSI PHY daughter board power gating and current measurement for safety
    [squishy-main.kicad_sch]
2024-02-19 squishy: main: re-synced the PCB and schematic, no layout yet, schematic still needs some work
    [squishy-main.kicad_pcb]
2024-02-23 squishy: main: Cleaned up the SCSI PHY current sense stuff and de-brain-sluged the PHY connector
    [squishy-main-power.kicad_sch, squishy-main.kicad_sch]
2024-02-23 squishy: main: Added an AC coupling cap to the refclk out from squishy
    [squishy-main.kicad_sch]
2024-02-23 squishy: main: Added notes about if we really want the 1v8 buck hanging off the 3v3 LDO, and that we might need to up the 3v3 LDO from 1A to larger
    [squishy-main-power.kicad_sch]
2024-02-23 squishy: main: Added flash configuration header
    [squishy-main.kicad_sch]
2024-02-24 squishy: main: Rough initial connection for the HyperRAM
    [squishy-main.kicad_pcb, squishy-main.kicad_sch]
2024-02-24 squishy: main: Rough initial connection for SD card
    [squishy-main.kicad_pcb, squishy-main.kicad_sch]
2024-02-24 squishy: main: rough initial connections for the ULPI PHY
    [squishy-main-usbfe.kicad_sch, squishy-main.kicad_pcb]
2024-02-24 squishy: main: Some final cleanup, made ERC clean, hooked up some more rough ordering for IO pins for the SCSI PHY, Replaced the 3v3 LDO with a buck due to other rails hanging off of it.
    [squishy-main-power.kicad_sch, squishy-main-usbfe.kicad_sch, squishy-main.kicad_pcb, squishy-main.kicad_sch]
2024-02-25 squishy: main: Added the missing footprint for Q7
    [squishy-main-power.kicad_sch, squishy-main.kicad_pcb, squishy-main.kicad_sch]
2024-02-25 squishy: main: some misc cleanup and tidying
    [squishy-main-power.kicad_sch, squishy-main.kicad_pcb, squishy-main.kicad_sch]
2024-02-25 squishy: main: some initial grouping and rough layout
    [squishy-main.kicad_pcb]
2024-02-26 squishy: main: Lots of work on the power supply side of things, along with some misc cleanup
    [squishy-main-power.kicad_sch, squishy-main-usbfe.kicad_sch, squishy-main.kicad_pcb, squishy-main.kicad_sch]
2024-02-26 squishy: main: Updated to KiCad v8, cleaned up ERC checks that resulted
    [squishy-main-power.kicad_sch, squishy-main-usbfe.kicad_sch, squishy-main.kicad_pcb, squishy-main.kicad_sch]
2024-02-27 squishy: main: Updated netclasses
    [squishy-main.kicad_pcb]
2024-03-03 squishy: main: Updated hyperram to add proper CS pullups
    [squishy-main.kicad_pcb, squishy-main.kicad_sch]
2024-03-20 squishy: main: Added a PSRAM connected to the FPGA and Supervisor MCU so we can temporarily cache a bitstream if we don't want to commit it to flash, thus saving on flash write cycles
    [squishy-main-usbfe.kicad_sch, squishy-main.kicad_pcb, squishy-main.kicad_sch]
2024-03-20 squishy: main: Removed the .kicad_prl, as it shouldn't have been included in the first place
2024-03-20 squishy: main: Added DC-IN polarity marking
    [squishy-main-power.kicad_sch, squishy-main.kicad_pcb]
2024-03-20 squishy: main: moved the DC Polarity graphic to the proper section of the schematic
    [squishy-main-power.kicad_sch, squishy-main.kicad_pcb]
2024-03-20 squishy: main: Added a pin-header footprint along with the SMA connector for the external trigger signal.
    This would let you use either an SMA cable or a standard 2.54mm pin header for triggering.
    [squishy-main.kicad_pcb, squishy-main.kicad_sch]
2024-03-21 squishy: main: Some initial cleanup and assignment of part numbers and mfrs, still much to do,
    [squishy-main-power.kicad_sch, squishy-main-usbfe.kicad_sch, squishy-main.kicad_pcb, squishy-main.kicad_sch]
2024-03-21 squishy: main: Some more sorting part numbers and just making sure things are kosher prior to a full proper schematic review
    [squishy-main-power.kicad_sch, squishy-main-usbfe.kicad_sch, squishy-main.kicad_pcb, squishy-main.kicad_sch]
2024-03-21 squishy: main: Some more part selection updates. Only a few left
    [squishy-main-power.kicad_sch, squishy-main-usbfe.kicad_sch, squishy-main.kicad_pcb]
2024-03-21 squishy: main: Fixed up the missing cap and re-layed out the bits around the DC in jack
    [squishy-main-power.kicad_sch, squishy-main.kicad_pcb]
2024-03-22 squishy: main: got a big chunk of the USB front end done, and some other clean up with the PSU and the low voltage LDOs
    [squishy-main-usbfe.kicad_sch, squishy-main.kicad_pcb]
2024-03-29 squishy: main: A whole lot of work, changed the board footprint, wiggled the ULPI, and fixed up a fair whack of pads needing thermals
    [squishy-main-power.kicad_sch, squishy-main-usbfe.kicad_sch, squishy-main.kicad_pcb, squishy-main.kicad_sch]
2024-03-29 squishy: main: A whole bunch of cleanup, also routed a large chunk of the supervisor
    [squishy-main-usbfe.kicad_sch, squishy-main.kicad_sch]
2024-03-30 squishy: main: hooked up the SD Card socket and spend a while fighting placing test points on the bottom only to just give up on that.
    Sadly we might need to cut a whole bunch of them, but I need to at least make sure the important ones can be accessed, ideally from the bottom of th board but with where the SD card socket is at the moment that's really unlikely, and that whole area in general is packed really tight so there isn't much room on top either.
    Maybe we can use some of the connector pads on top as test points, which we need for the MCU and flash, those are the two really big important bits that need test points for automated programming in a fixture, but mounting the board upside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
    [squishy-main.kicad_sch]
2024-04-01 squishy: main: A whole lotta work on getting test points squished in, also got the power switch and current sensing for the SCSI PHY power bits sorted
    [squishy-main-power.kicad_sch, squishy-main.kicad_sch]
2024-04-09 squishy: main: Huge chunk of changes, need to re-do the SCSI mezz pinout but it's getting there
    [squishy-main.kicad_sch]
2024-04-15 squishy: main: cleaning up the schematics, also routed the `SEPIC_GOOD` to the POR rather than just relying on the 5V from the SEPIC output to kick on the rest of the power tree
    [squishy-main-power.kicad_sch, squishy-main-usbfe.kicad_sch, squishy-main.kicad_sch]
2024-04-15 squishy: main: added proper tolerances to the resistors and capacitors
    [squishy-main-power.kicad_sch, squishy-main-usbfe.kicad_sch, squishy-main.kicad_sch]
2024-04-17 squishy: main: Fixed up some oopsies that happened when moving the PHY Power CSA and ADC to another sheet,
2024-05-15 boards: main: Adjusted the trans-flag LED resistors to be 2k. Also added a blank TVS Diode for the trigger input
    [squishy-main-power.kicad_sch, squishy-main-usbfe.kicad_sch, squishy-main.kicad_sch]
2024-05-15 squishy: main: Populated the TVS Diode part and added a footprint, also still futtsing with the resistor values for the LEDs
    [squishy-main.kicad_sch]
2024-05-29 squishy: main: Hooked up the HyperRAM, need to wiggle it into shape still
    [squishy-main.kicad_sch]
2024-05-31 contrib: Pulled in the changes from azonenberg/pcb-checklist for the schematic and board design checklist
2024-05-31 squishy: main: Added a pullup to the gateware flash
    [squishy-main.kicad_sch]
2024-06-01 squishy: main: Added note about SDCard switch
    [squishy-main.kicad_sch]
2024-06-03 squishy: main: some rough cap placement
    [squishy-main-power.kicad_sch, squishy-main-usbfe.kicad_sch, squishy-main.kicad_sch]
2024-06-05 squishy: main: Re-jigged the HyperRAM pinout to improve the base length matching characteristics
    [squishy-main.kicad_sch]
2024-06-05 squishy: main: updated the ADC footprint
    [squishy-main-power.kicad_sch, squishy-main.kicad_sch]
2024-06-05 squishy: main: Fixed typo in property, `s/Tolerrance/Tolerance/`
    [squishy-main.kicad_sch]
2024-06-06 squishy: main: downsized the caps that belong under the FPGA, I didn't want to use 0201's but there just isn't room
    [squishy-main-power.kicad_sch, squishy-main-usbfe.kicad_sch]
2024-06-06 squishy: main: Added a note about the ECP5-5G DCU power strapping
    [squishy-main-usbfe.kicad_sch]
2024-06-07 squishy: main: Added missing pullups to FPGA config lines, and adjusted soldermask expansion
    [squishy-main.kicad_sch]
2024-06-08 squishy: main: More capacitor layout, FPGA should be good to go
    [squishy-main-power.kicad_sch, squishy-main-usbfe.kicad_sch]
2024-06-08 squishy: main: Got the SCSI PHY bus mostly sorted out and did a lot of work on the power net, not too far now
    [squishy-main-power.kicad_sch, squishy-main.kicad_sch]
2024-06-09 squishy: main: moved part of the +1v8 enable line for the FPGA core voltage LDOs to In2.Cu from the power plane In4.Cu so we don't cut off the +3v3 pour on that layer when we extract the core voltages
2024-06-10 squishy: main: Doing some silkscreen work
2024-06-10 squishy: main: power pours are done, 0 unrouted nets!
2024-06-10 squishy: main: Cleaned up ERC, schematic is now squeaky clean pending any catastrophic oversights on my part.
    [squishy-main-power.kicad_sch, squishy-main.kicad_sch]
2024-06-10 squishy: main: brought the PCB design up to date with the clean schematic in preparation for DCR
2024-06-10 squishy: main: DRC is like 99% clean, there might be a KiCad bug we're hitting with the length matching and skew rules
2024-06-10 squishy: main: fighting with the SCSI bus DRC because I think we're hitting internal KiCad bugs with rounding and trace length calculations
2024-06-10 squishy: main: DRC is clean, I'm 99.9999% sure the KiCad length tuning tool is busted
2024-06-10 squishy: main: some silkscreen work
2024-06-11 squishy: main: some more silkscreen work
2024-06-11 squishy: main: last little silkscreen cleanup, now time for the start of review
2024-06-11 squishy: main: started populating part links prior to going through each part (other than passives) and validating their footprints
    [squishy-main-power.kicad_sch, squishy-main-usbfe.kicad_sch, squishy-main.kicad_sch]
2024-06-11 squishy: main: added the last of the Digikey order codes and URLs, some parts are not available at DigiKey and others are out of stock with long lead times, need to find alternatives. While also ther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
    [squishy-main-power.kicad_sch, squishy-main-usbfe.kicad_sch, squishy-main.kicad_sch]
2024-06-11 squishy: main: BoM cleanup and alternative part selection for the ones which were out of stock
    [squishy-main-power.kicad_sch, squishy-main-usbfe.kicad_sch, squishy-main.kicad_sch]
2024-06-11 squishy: main: Replaced the single 4k7 resistor network with 4 dedicated resistors to reduce BOM count
    [squishy-main.kicad_sch]
2024-06-11 squishy: main: updated part fields to be more generic
    [squishy-main-power.kicad_sch, squishy-main-usbfe.kicad_sch, squishy-main.kicad_sch]
2024-06-12 squishy: main: fixed the pinout of the 100MHz and 200MHz LVDS oscillators, had to swap CLK+ and CLK- but because they're LVDS it shouldn't matter:tm:
    [squishy-main-usbfe.kicad_sch, squishy-main.kicad_sch]
2024-06-12 squishy: main: fixed up LED values
    [squishy-main-power.kicad_sch, squishy-main.kicad_sch]
2024-06-12 squishy: main: fixed the pinout for the bitstream cache PSRAM
    [squishy-main.kicad_sch]
2024-06-12 squishy: main: fixed the 1v8 buck regulator footprint
    [squishy-main-power.kicad_sch]
2024-06-12 squishy: main: fixed datasheet for the CHONK scr.
    [squishy-main-power.kicad_sch]
2024-06-12 squishy: main: notched the paste on the L3 inductor for the 3v3 buck converter
2024-06-12 squishy: main: Fixed the paste on the Q1 FET on the SEPIC supply so it's not a giant hole in the stencil
2024-06-12 squishy: main: ensured DRC was clean, snubbed the new DRC warning from the alterations for the trigger connector paste layer
2024-06-12 squishy: main: Added a note in the schematic about the SCSI PHY `TERMPWR_EN` signal, and how the pullup/pulldown/drive-limiting resistor needs to be provided by the PHY module itself due to potential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
    [squishy-main.kicad_sch]
2024-06-12 squishy: main: Added a note about the ULPI clock input into the FPGA
    [squishy-main-usbfe.kicad_sch]
2024-06-12 rev2-evt: mainboard: Completed Schematic Checklist
2024-06-13 rev2-evt: mainboard: Completed Gerber generation and validation, layout checklist completed
    [squishy-main-B_Cu.gbl, squishy-main-B_Mask.gbs, squishy-main-B_Paste.gbp, squishy-main-B_Silkscreen.gbo, squishy-main-Edge_Cuts.gm1, squishy-main-F_Cu.gtl, squishy-main-F_Mask.gts, squishy-main-F_Paste.gtp]
2024-06-13 rev2-evt: mainboard: generated pick and place centroid files and BOM
    [squishy-main-bom.csv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]
2024-06-13 rev2-evt: mainboard: generated CAM data for panelized mainboarrd
    [squishy-main-panel-B_Cu.gbl, squishy-main-panel-B_Mask.gbs, squishy-main-panel-B_Paste.gbp, squishy-main-panel-B_Silkscreen.gbo, squishy-main-panel-Edge_Cuts.gm1, squishy-main-panel-F_Cu.gtl, squishy-main-panel-F_Mask.gts, squishy-main-panel-F_Paste.gtp]
2024-06-13 rev2-evt: mainboard: generated cendroid files for manboard panel
    [squishy-main-panel-bottom-pos.csv, squishy-main-panel-top-pos.csv]
2024-06-14 squishy: main: Fixed FPGA LED Net ordering and indexing to match silk screen
    [squishy-main.kicad_sch]
2024-06-14 squishy: main: Fixed a typo on the USB-PD control lines, was PD_SCA, should have been PD_SDA
    [squishy-main-usbfe.kicad_sch]
2024-06-14 squishy: main: updated sheet dates
    [squishy-main-power.kicad_sch, squishy-main-usbfe.kicad_sch, squishy-main.kicad_sch]
2024-06-14 squishy: main: altered the solder mask expansion to be more correct
2024-06-14 rev2-evt: mainboard: Generated updated CAM files for the net name updates
    [squishy-main-B_Cu.gbl, squishy-main-B_Mask.gbs, squishy-main-B_Paste.gbp, squishy-main-B_Silkscreen.gbo, squishy-main-Edge_Cuts.gm1, squishy-main-F_Cu.gtl, squishy-main-F_Mask.gts, squishy-main-F_Paste.gtp]
2024-06-14 rev2-evt: manboard: re-generated the CAM data for the panel
    [squishy-main-panel-B_Cu.gbl, squishy-main-panel-B_Mask.gbs, squishy-main-panel-B_Paste.gbp, squishy-main-panel-B_Silkscreen.gbo, squishy-main-panel-Edge_Cuts.gm1, squishy-main-panel-F_Cu.gtl, squishy-main-panel-F_Mask.gts, squishy-main-panel-F_Paste.gtp]
2024-06-21 sqiushy: main: Added some direction control signals that were missing from the PHY connection
    [squishy-main.kicad_sch]
2024-06-21 squishy: main: Added a handful of low-speed control signals for use in whatever we may possibly need in the future, hopefully to avoid having to re-spin the mainboard
    [squishy-main.kicad_sch]
2024-06-21 squishy: main: Fixed export paths because KiCad forgor
    [squishy-main.kicad_sch]
2024-06-21 rev2-evt: mainboard: Re-generated standalone gerbers for recent changes
    [squishy-main-B_Cu.gbl, squishy-main-B_Mask.gbs, squishy-main-B_Paste.gbp, squishy-main-B_Silkscreen.gbo, squishy-main-Edge_Cuts.gm1, squishy-main-F_Cu.gtl, squishy-main-F_Mask.gts, squishy-main-F_Paste.gtp]
2024-06-21 rev2-evt: mainboard: panel: Re-generated panel gerbers with latest changes
    [squishy-main-panel-B_Cu.gbl, squishy-main-panel-B_Mask.gbs, squishy-main-panel-B_Paste.gbp, squishy-main-panel-B_Silkscreen.gbo, squishy-main-panel-Edge_Cuts.gm1, squishy-main-panel-F_Cu.gtl, squishy-main-panel-F_Mask.gts, squishy-main-panel-F_Paste.gtp]
2024-06-22 contrib: Updated board-to-board doc
2024-07-07 squishy: phy: stubbed out the SE phy board
    [squishy-phy-se.kicad_pcb, squishy-phy-se.kicad_sch]
2024-07-07 squishy: phy: stubbed out the LVD phy board
    [squishy-phy-lvd.kicad_pcb, squishy-phy-lvd.kicad_sch]
2024-07-07 squishy: phy: stubbed out the HVD phy board
    [squishy-phy-hvd.kicad_pcb, squishy-phy-hvd.kicad_sch]
2024-07-07 squishy: phy: stubbed out the LVD/MSE phy board
    [squishy-phy-lvd-mse.kicad_pcb, squishy-phy-lvd-mse.kicad_sch]
2024-07-18 squishy: main: Replaced the 48MHz XO for the supervisor with a 32MHz XO because I can't read apparently
    [squishy-main.kicad_sch]
2024-07-18 squishy: main: Fixed the alt-mode pin settings on the MCU after nearly having a panic attack that it was off
    [squishy-main.kicad_sch]
2024-08-18 squishy: phy: lvd: Large chunk of work on the LVD phy,
    still needs diffsense and termpwr bits implemented and then it can be routed
    [squishy-lvd-phy-termination.kicad_sch, squishy-lvd-phy-transceivers.kicad_sch, squishy-phy-lvd.kicad_pcb, squishy-phy-lvd.kicad_sch]
2024-08-31 squishy: phy: updated the pinout to the connector module to allow for +3v3 so we can power the ID chip on the board
    [squishy-lvd-phy-termination.kicad_sch, squishy-lvd-phy-transceivers.kicad_sch, squishy-phy-hvd.kicad_sch, squishy-phy-lvd-mse.kicad_sch, squishy-phy-lvd.kicad_sch, squishy-phy-se.kicad_sch]
2024-08-31 squishy: phy: Added debug/programming connector for the PHY EEPROMs
    [squishy-phy-hvd.kicad_sch, squishy-phy-lvd-mse.kicad_sch, squishy-phy-lvd.kicad_sch, squishy-phy-se.kicad_sch]
2024-08-31 squishy: connectors: Initial LVD/MSE/SE 50-pin IDC connector stub
    [mse-50-idc.kicad_pcb, mse-50-idc.kicad_sch]
2024-08-31 squishy: connectors: Initial LVD/MSE/SE 50-pin Centronics connector stub
    [mse-50-ce.kicad_pcb, mse-50-ce.kicad_sch]
2024-08-31 squishy: connectors: Initial LVD/MSE/SE 50-pin micro-d-sub (HD) connector stub
    [mse-50-hd.kicad_pcb, mse-50-hd.kicad_sch]
2024-08-31 squishy: connectors: Initial LVD/MSE/SE 68-pin micro-d-sub (HD) connector stub
    [mse-68-hd.kicad_pcb, mse-68-hd.kicad_sch]
2024-08-31 squishy: connectors: Initial LVD/MSE/SE 68-pin VHDCI connector stub
    [mse-68-vhdci.kicad_pcb, mse-68-vhdci.kicad_sch]
2024-08-31 squishy: connectors: Initial HVD 50-pin IDC connector stub
    [hvd-50-idc.kicad_pcb, hvd-50-idc.kicad_sch]
2024-08-31 squishy: connectors: Initial HVD 50-pin Centronics connector stub
    [hvd-50-ce.kicad_pcb, hvd-50-ce.kicad_sch]
2024-08-31 squishy: connectors: Initial HVD 50-pin mini-d-sub (HD) connector stub
    [hvd-50-hd.kicad_pcb, hvd-50-hd.kicad_sch]
2024-08-31 squishy: connectors: Initial HVD 68-pin mini-d-sub (HD) connector stub
    [hvd-68-hd.kicad_pcb, hvd-68-hd.kicad_sch]
2024-08-31 squishy: connectors: Initial HVD 68-pin VHDCI connector stub
    [hvd-68-vhdci.kicad_pcb, hvd-68-vhdci.kicad_sch]
2024-08-31 squishy: connectors: Initial SCSI2 HVD/SE 68-pin mini-d-sub (HD) connector stub
    [scsi2-68-hd.kicad_pcb, scsi2-68-hd.kicad_sch]
2024-08-31 squishy: connectors: Initial HVD/LVD/SE 80-pin SCA-2 connector stub
    [all-80-sca.kicad_pcb, all-80-sca.kicad_sch]
2024-09-01 squishy: connectors: Removed unneeded connector symbols in the given kicad schematics
    [all-80-sca.kicad_sch, hvd-50-ce.kicad_sch, hvd-50-hd.kicad_sch, hvd-50-idc.kicad_sch, hvd-68-hd.kicad_sch, hvd-68-vhdci.kicad_sch, mse-50-ce.kicad_sch, mse-50-hd.kicad_sch]
2024-09-01 squishy: phy: Added pull-downs on the LVD PHY enables to ensure output bus is High-Z on power up
    [squishy-lvd-phy-transceivers.kicad_sch]
2024-09-02 squishy: connectors: Built the connector pinout for the 68-pin HD LVD/MSE/SE connector board
    [mse-68-hd.kicad_sch]
2024-09-02 squishy: connectors: Defined the impedance requirements, adjusted the stackup, and shortened the board for the 68-pin HD LVD/MSE/SE connector module
    [mse-68-hd.kicad_pcb]
2024-09-02 squishy: connectors: Routed out the first half of the HVD/LVD/SE 68-pin connector module
    [mse-68-hd.kicad_pcb, mse-68-hd.kicad_sch]
2024-09-03 squishy: connectors: Propagated changes from mse-68-hd PCB and DRC rules to scsi2-68-hd
    [scsi2-68-hd.kicad_pcb]
2024-09-03 squishy: connectors: Propagated changes from mse-68-hd PCB and DRC rules to mse-68-vhdci
    [mse-68-vhdci.kicad_pcb]
2024-09-03 squishy: connectors: Propagated changes from mse-68-hd PCB and DRC rules to mse-50-idc
    [mse-50-idc.kicad_pcb]
2024-09-03 squishy: connectors: Propagated changes from mse-68-hd PCB and DRC rules to mse-50-hd
    [mse-50-hd.kicad_pcb]
2024-09-03 squishy: connectors: Propagated changes from mse-68-hd PCB and DRC rules to mse-50-ce
    [mse-50-ce.kicad_pcb]
2024-09-03 squishy: connectors: Propagated changes from mse-68-hd PCB and DRC rules to hvd-68-vhdci
    [hvd-68-vhdci.kicad_pcb]
2024-09-03 squishy: connectors: Propagated changes from mse-68-hd PCB and DRC rules to hvd-68-hd
    [hvd-68-hd.kicad_pcb]
2024-09-03 squishy: connectors: Propagated changes from mse-68-hd PCB and DRC rules to hvd-50-idc
    [hvd-50-idc.kicad_pcb]
2024-09-03 squishy: connectors: Propagated changes from mse-68-hd PCB and DRC rules to hvd-68-ce
    [hvd-50-ce.kicad_pcb]
2024-09-03 squishy: connectors: Propagated changes from mse-68-hd PCB and DRC rules to all-80-sca
    [all-80-sca.kicad_pcb]
2024-09-03 squishy: phy: added `DIFFSENS` discriminator to the LVD PHY
    [squishy-lvd-phy-termination.kicad_sch, squishy-phy-lvd.kicad_sch]
2024-09-04 squishy: connectors: Routed out the rest of the connector, shortening the board to 34mm, and began length matching
    [mse-68-hd.kicad_pcb]
2024-09-04 squishy: connectors: Completed length matchinig and added sheild handling to the 68-pin HD LVD/MSE/SE connector module
    [mse-68-hd.kicad_pcb, mse-68-hd.kicad_sch]
2024-09-11 squishy: connectors: Propagated changes from mse-68-hd DRC rules to mse-68-vhdci
2024-09-11 squishy: connectors: Propagated changes from mse-68-hd DRC rules to scsi2-68-hd
2024-09-11 squishy: connectors: Propagated changes from mse-68-hd DRC rules to mse-50-idc
2024-09-11 squishy: connectors: Propagated changes from mse-68-hd DRC rules to mse-50-hd
2024-09-11 squishy: connectors: Propagated changes from mse-68-hd DRC rules to mse-50-ce
2024-09-11 squishy: connectors: Propagated changes from mse-68-hd DRC rules to hvd-68-vhdci
2024-09-11 squishy: connectors: Propagated changes from mse-68-hd DRC rules to hvd-68-hd
2024-09-11 squishy: connectors: Propagated changes from mse-68-hd DRC rules to hvd-50-idc
2024-09-11 squishy: connectors: Propagated changes from mse-68-hd DRC rules to hvd-50-hd
2024-09-11 squishy: connectors: Propagated changes from mse-68-hd DRC rules to hvd-50-ce
2024-09-11 squishy: connectors: Propagated changes from mse-68-hd DRC rules to all-80-sca
2024-09-15 squishy: connectors: hooked up hd-50-ce connector
    [hvd-50-ce.kicad_pcb, hvd-50-ce.kicad_sch]
2024-09-15 squishy: connectors: hooked up hd-50-hd connector
    [hvd-50-hd.kicad_pcb, hvd-50-hd.kicad_sch]
2024-09-15 squishy: connectors: hooked up hd-50-idc connector
    [hvd-50-idc.kicad_pcb, hvd-50-idc.kicad_sch]
2024-09-15 squishy: connectors: hooked up hd-68-hd connector
    [hvd-68-hd.kicad_pcb, hvd-68-hd.kicad_sch]
2024-09-15 squishy: connectors: hooked up hd-68-vhdci connector
    [hvd-68-vhdci.kicad_pcb, hvd-68-vhdci.kicad_sch]
2024-09-15 squishy: connectors: hooked up mse-50-ce connector
    [mse-50-ce.kicad_pcb, mse-50-ce.kicad_sch]
2024-09-15 squishy: connectors: hooked up mse-50-hd connector
    [mse-50-hd.kicad_pcb, mse-50-hd.kicad_sch]
2024-09-15 squishy: connectors: hooked up mse-50-idc connector
    [mse-50-idc.kicad_pcb, mse-50-idc.kicad_sch]
2024-09-15 squishy: connectors: hooked up mse-68-vhdci connector
    [mse-68-vhdci.kicad_pcb, mse-68-vhdci.kicad_sch]
2024-09-15 squishy: connectors: Updated netclass patterns for connector boards
2024-09-15 squishy: connectors: updated SCSI_PHY netclass settings the cheeky way (in a text editor)
2024-09-15 squishy: connectors: Updated netclass pattern to be actually correct, oops
2024-09-15 squishy: connectors: Fixed the pour layers and added TERMPWR stitching for all-80-sca
    [all-80-sca.kicad_pcb]
2024-09-15 squishy: connectors: Fixed the pour layers and added TERMPWR stitching for hvd-50-ce
    [hvd-50-ce.kicad_pcb]
2024-09-15 squishy: connectors: Fixed the pour layers and added TERMPWR stitching for hvd-50-hd
    [hvd-50-hd.kicad_pcb]
2024-09-15 squishy: connectors: Fixed the pour layers and added TERMPWR stitching for hvd-50-idc
    [hvd-50-idc.kicad_pcb]
2024-09-15 squishy: connectors: Fixed the pour layers and added TERMPWR stitching for hvd-68-hd
    [hvd-68-hd.kicad_pcb]
2024-09-15 squishy: connectors: Fixed the pour layers and added TERMPWR stitching for hvd-68-vhdci
    [hvd-68-vhdci.kicad_pcb]
2024-09-15 squishy: connectors: Fixed the pour layers and added TERMPWR stitching for mse-50-ce
    [mse-50-ce.kicad_pcb]
2024-09-15 squishy: connectors: Fixed the pour layers and added TERMPWR stitching for mse-50-hd
    [mse-50-hd.kicad_pcb]
2024-09-15 squishy: connectors: Fixed the pour layers and added TERMPWR stitching for mse-50-idc
    [mse-50-idc.kicad_pcb]
2024-09-15 squishy: connectors: Fixed the pour layers and added TERMPWR stitching for mse-68-vhdci
    [mse-68-vhdci.kicad_pcb]
2024-09-15 squishy: connectors: Fixed the pour layers and added TERMPWR stitching for scsi2-68-hd
    [scsi2-68-hd.kicad_pcb]
2024-09-16 squishy: connectors: Adjusted the CE-50 connector to have a less conservative courtyard to allow us scoot the connector back for more board support.
    [hvd-50-ce.kicad_pcb, mse-50-ce.kicad_pcb]
2024-09-16 squishy: connectors: Fixed up the silkscreen on the EEPYROM programming header
    [all-80-sca.kicad_pcb, hvd-50-ce.kicad_pcb, hvd-50-hd.kicad_pcb, hvd-50-idc.kicad_pcb, hvd-68-hd.kicad_pcb, hvd-68-vhdci.kicad_pcb, mse-50-ce.kicad_pcb, mse-50-hd.kicad_pcb]
2024-09-17 squishy: connectors: Cleaned up and unified look/feel of connector schematics
    [all-80-sca.kicad_sch, hvd-50-ce.kicad_sch, hvd-50-hd.kicad_sch, hvd-50-idc.kicad_sch, hvd-68-hd.kicad_sch, hvd-68-vhdci.kicad_sch, mse-50-ce.kicad_sch, mse-50-hd.kicad_sch]
2024-09-17 squishy: connectors: updated schematic title blocks for connectors as appropriate
    [all-80-sca.kicad_sch, hvd-50-ce.kicad_sch, hvd-50-hd.kicad_sch, hvd-50-idc.kicad_sch, hvd-68-hd.kicad_sch, hvd-68-vhdci.kicad_sch, mse-50-ce.kicad_sch, mse-50-hd.kicad_sch]
2024-09-17 squishy: connectors: updated pcb title blocks for connectors as appropriate
    [all-80-sca.kicad_pcb, hvd-50-ce.kicad_pcb, hvd-50-hd.kicad_pcb, hvd-50-idc.kicad_pcb, hvd-68-hd.kicad_pcb, hvd-68-vhdci.kicad_pcb, mse-50-ce.kicad_pcb, mse-50-hd.kicad_pcb]
2024-09-19 squishy: connectors: s/DP12/DB12/g s/DP14/DB14/g
    [all-80-sca.kicad_sch, hvd-50-ce.kicad_sch, hvd-50-hd.kicad_sch, hvd-50-idc.kicad_sch, hvd-68-hd.kicad_sch, hvd-68-vhdci.kicad_sch, mse-50-ce.kicad_sch, mse-50-hd.kicad_sch]
2024-09-19 squishy: connectors: Schematic cleanup for mse-68-hd
    [mse-68-hd.kicad_pcb, mse-68-hd.kicad_sch]
2024-09-19 squishy: connectors: Begun routing for hvd-68-hd, adjusting connector alignment
    [hvd-68-hd.kicad_pcb, hvd-68-hd.kicad_sch]
2024-09-19 squishy: connectors: updated the trace width for the HVD connectors that are not yet routed
2024-09-20 contrib: Updated the board-to-board interconnect document, needs to be merged into the upstream docs eventually:tm:
2024-09-20 squishy: connectors: added little earbs to the hvd-50-ce connector board
    [hvd-50-ce.kicad_pcb]
2024-09-20 squishy: connectors: added little earbs to the mse-50-ce connector board
    [mse-50-ce.kicad_pcb]
2024-09-23 squishy: phy: lvd: Added termination power LDO for LVD termination
    [squishy-lvd-phy-termination.kicad_sch]
2024-09-23 squishy: phy: lvd: Fixed up the DIFFSENSE detection and sourcing, as well as added TERMWPR control
    [squishy-phy-lvd.kicad_sch]
2024-09-26 squishy: phy: lvd: updated the PCB with the mostly finished schematic bits.
    [squishy-lvd-phy-termination.kicad_sch, squishy-phy-lvd.kicad_pcb, squishy-phy-lvd.kicad_sch]
2024-09-27 squishy: connectors: fixed minor error in the total length compensation for the wiggles in the mse-68-hd connector (math is hard)
    [mse-68-hd.kicad_pcb]
2024-09-28 squishy: connectors: started routing on the hvd-50-ce
    [hvd-50-ce.kicad_pcb]
2024-09-28 squishy: connectors: updated SCSI connector metadata for hvd-50-ce
    [hvd-50-ce.kicad_sch]
2024-09-28 squishy: connectors: updated SCSI connector metadata for hvd-50-hd
    [hvd-50-hd.kicad_sch]
2024-09-28 squishy: connectors: updated SCSI connector metadata for hvd-50-idc
    [hvd-50-idc.kicad_sch]
2024-09-28 squishy: connectors: updated SCSI connector metadata for hvd-68-hd
    [hvd-68-hd.kicad_sch]
2024-09-28 squishy: connectors: updated SCSI connector metadata for hvd-68-vhdci
    [hvd-68-vhdci.kicad_sch]
2024-09-28 squishy: connectors: updated SCSI connector metadata for mse-50-ce
    [mse-50-ce.kicad_sch]
2024-09-28 squishy: connectors: updated SCSI connector metadata for mse-50-hd
    [mse-50-hd.kicad_sch]
2024-09-28 squishy: connectors: updated SCSI connector metadata for mse-68-hd
    [mse-68-hd.kicad_sch]
2024-09-28 squishy: connectors: updated SCSI connector metadata for mse-68-vhdci
    [mse-68-vhdci.kicad_sch]
2024-09-29 squishy: connectors: Length matched the SCSI routing on the hvd-68-hd connector interface
    [hvd-68-hd.kicad_pcb]
2024-09-30 squishy: connectors: Roughly routed out the hd-50-ce connector, still needs wiggles
    [hvd-50-ce.kicad_pcb]
2024-09-30 squishy: connectors: added shield cap/resistor to hd-50-ce
    [hvd-50-ce.kicad_pcb]
2024-09-30 squishy: connectors: Routed and length matched the mse-50-hd connector interface
    [mse-50-hd.kicad_pcb, mse-50-hd.kicad_sch]
2024-09-30 squishy: connectors: Fixed a via size error on the mse-50-hd connector interface
    [mse-50-hd.kicad_pcb]
2024-09-30 squishy: connectors: Fixed some missing ground vias on the mse-50-hd connector interface
    [mse-50-hd.kicad_pcb]
2024-09-30 squishy: connectors: Routed and length matched the hvd-50-hd connector interface
    [hvd-50-hd.kicad_pcb, hvd-50-hd.kicad_sch]
2024-10-02 Added 1b2 part keys.
    [squishy-main-power.kicad_sch, squishy-main-usbfe.kicad_sch, squishy-main.kicad_sch]
2024-10-03 squishy: main: pulled in small errata fixes from the schematic and applied them to the PCB
2024-10-03 squishy: main: Set paths for POS and BOM exports
2024-10-03 release: rev2-evt: mainboard: Updated BOM and position files
    [squishy-main-bom.csv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]
2024-10-03 release: rev2-evt: mainboard: panel: Updated pnp pos files
    [squishy-main-panel-bottom-pos.csv, squishy-main-panel-top-pos.csv]
2024-10-11 squishy: connectors: Routed and done initial length matching on the mse-68-vhdci connector interface
    [mse-68-vhdci.kicad_pcb]
2024-10-12 squishy: main: Fixed SEPIC MOSFET `Q1`'s symbol, Drain and Source were swapped.
    [squishy-main-power.kicad_sch]
2024-10-12 squishy: main: fixed LDO `BIAS` pin on `U16`/`U17`/`U20`, was floating, should have been connected to `Vin` for the LDO
    [squishy-main-power.kicad_sch]
2024-10-12 squishy: main: Fixed swap of `SWDIO`/`SWCLK` on `J4`
    [squishy-main.kicad_sch]
2024-10-12 squishy: main: hopefully fixed the SERCOM pinning for the FPGA SPI line, unsure if we're keeping the SAMD or switching to an STM32
    [squishy-main.kicad_sch]
2024-10-12 releases: rev2-evt: Added minor errata note about the 3v3 rail being more like 3v223, within spec but slightly low
2024-10-17 squishy: connectors: Adjustments for ERC and DRC cleanliness for hvd-50-hd connector interface board
    [hvd-50-hd.kicad_pcb, hvd-50-hd.kicad_sch]
2024-10-17 squishy: connectors: Adjustments for ERC and DRC cleanliness for mse-50-hd connector interface board
    [mse-50-hd.kicad_pcb, mse-50-hd.kicad_sch]
2024-10-17 squishy: connectors: Adjustments for ERC and DRC cleanliness for hvd-68-hd connector interface board
    [hvd-68-hd.kicad_pcb, hvd-68-hd.kicad_sch]
2024-10-17 squishy: connectors: Adjustments for ERC and DRC cleanliness for mse-68-hd connector interface board
    [mse-68-hd.kicad_pcb, mse-68-hd.kicad_sch]
2024-10-17 contrib: Added a helper script to batch generate CAM files for the kicad projects
2024-10-17 squishy: connectors: Added in-progress TODO list
2024-10-17 contrib: fixed missing arg for the drill generation
2024-10-17 squishy: connectors: Length matched, and done ERC and DRC adjustments for cleanliness for the mse-68-vhdci connector interface board
    [mse-68-vhdci.kicad_pcb, mse-68-vhdci.kicad_sch]
2024-10-20 squishy: connectors: cleaned up ERC on the hd-50-ce connector
    [hvd-50-ce.kicad_sch]
2024-10-20 squishy: connectors: ensured the hd-50-ce connector was routed and updated the KiKit tab symbols
    [hvd-50-ce.kicad_pcb]
2024-10-20 squishy: connectors: cleaned up ERC on the hd-50-idc
    [hvd-50-idc.kicad_sch]
2024-10-20 squishy: connectors: cleaned up ERC on the hd-68-vhdci connector
    [hvd-68-vhdci.kicad_sch]
2024-10-20 squishy: connectors: cleaned up ERC on the mse-50-ce connector
    [mse-50-ce.kicad_sch]
2024-10-20 squishy: connectors: updated the KiKit tab footprints on the mse-50-ce
    [mse-50-ce.kicad_pcb]
2024-10-20 squishy: connectors: cleaned up ERC on the mse-50-idc connector
    [mse-50-idc.kicad_sch]
2024-10-20 squishy: connectors: updated the KiKit tab footprints on the mse-50-idc connector
    [mse-50-idc.kicad_pcb]
2024-10-25 squishy: connectors: routed the hvd-50-idc connector
    [hvd-50-idc.kicad_pcb]
2024-10-25 squishy: connectors: updated the TODO list noting the mse-68-vhdci connector has been routed and length matched
2024-10-25 squishy: connectors: Normalized the use of `X` vs `x` for marking an item complete
2024-10-25 squishy: connectors: rough initial routing of the mse-50-ce connector board
    [mse-50-ce.kicad_pcb]
2024-10-25 squishy: connectors: Made a couple of small corrections to the mse-68-vhdci connector interface
    [mse-68-vhdci.kicad_pcb]
2024-10-25 squishy: connectors: Routed all and length matched half of the hvd-68-vhdci connector interface
    [hvd-68-vhdci.kicad_pcb, hvd-68-vhdci.kicad_sch]
2024-10-25 squishy: connectors: re-routed the hvd-50-ce board
    [hvd-50-ce.kicad_pcb]
2024-10-26 squishy: connectors: routed the mse-50-idc board
    [mse-50-idc.kicad_pcb]
2024-10-27 squishy: connectors: Re-ordered the TODO list to move the crossed out items to the bottom
2024-10-27 squishy: connectors: Fixed the board outline on the hvd/mse 50-ce connector PCBs
    [hvd-50-ce.kicad_pcb, mse-50-ce.kicad_pcb]
2024-10-29 squishy: connectors: Finished length matching the hvd-68-vhdci connector interface
    [hvd-68-vhdci.kicad_pcb]
2024-11-07 squishy: connectors: got rid of `all-80-sca` and `scsi2-68-hd`
    Two reasons for this, the first being that we don't have all the signals needed for them on the connector board from the PHY, and the second being that you just can't seem to get new 80-pin SCA-2 connectors anymore
    [all-80-sca.kicad_pcb, all-80-sca.kicad_sch, scsi2-68-hd.kicad_pcb, scsi2-68-hd.kicad_sch]
2024-11-07 squishy: connectors: length-matched hvd-50-ce
    [hvd-50-ce.kicad_pcb]
2024-11-07 squishy: connectors: cleaned DRC for hvd-50-ce
    [hvd-50-ce.kicad_pcb]
2024-11-07 squishy: connectors: Adjusted the length matching on the mse-68-hd connector interface
    [mse-68-hd.kicad_pcb]
2024-11-07 squishy: connectors: Adjusted the length matching on the mse-50-hd connector interface
    [mse-50-hd.kicad_pcb]
2024-11-07 squishy: connectors: Adjusted the length matching on the hvd-68-hd connector interface
    [hvd-68-hd.kicad_pcb]
2024-11-07 squishy: connectors: Adjusted the length matching on the hvd-50-hd connector interface
    [hvd-50-hd.kicad_pcb]
2024-11-07 squishy: connectors: length-matched hvd-50-idc
    [hvd-50-idc.kicad_pcb]
2024-11-07 squishy: connectors: cleaned DRC for hvd-50-idc
    [hvd-50-idc.kicad_pcb]
2024-11-07 squishy: connectors: Adjusted the length matching on the mse-68-vhdci connector interface
    [mse-68-vhdci.kicad_pcb]
2024-11-07 squishy: connectors: fixed the pad-to-die length on the connectors for hvd-50-ce
    Also KiCad needs some meds, it has a hard time with trace length matchings occasionally
    [hvd-50-ce.kicad_pcb]
2024-11-07 squishy: connectors: length-matched mse-50-ce
    [mse-50-ce.kicad_pcb]
2024-11-07 squishy: connectors: cleaned up DRC on mse-50-ce
    [mse-50-ce.kicad_pcb]
2024-11-07 squishy: connectors: length-matched mse-50-idc
    [mse-50-idc.kicad_pcb]
2024-11-07 squishy: connectors: cleaned up DRC on mse-50-idc
    [mse-50-idc.kicad_pcb]
2024-11-07 squishy: connectors: Added silkscreen and layer markers to the MSE connector interface boards
    [mse-50-ce.kicad_pcb, mse-50-hd.kicad_pcb, mse-50-idc.kicad_pcb, mse-68-hd.kicad_pcb, mse-68-vhdci.kicad_pcb]
2024-11-07 squishy: connectors: Added silkscreen and layer markers to the HVD connector interface boards
    [hvd-50-ce.kicad_pcb, hvd-50-hd.kicad_pcb, hvd-50-idc.kicad_pcb, hvd-68-hd.kicad_pcb, hvd-68-vhdci.kicad_pcb]
2024-11-07 squishy: connectors: Ensured the MSE boards had their fills re-poured
    [mse-50-ce.kicad_pcb, mse-50-hd.kicad_pcb, mse-50-idc.kicad_pcb, mse-68-hd.kicad_pcb, mse-68-vhdci.kicad_pcb]
2024-11-07 squishy: connectors: updated part metadata on hd-50-ce prior to CAM generation
    [hvd-50-ce.kicad_sch]
2024-11-07 squishy: connectors: updated part metadata on hd-50-hd prior to CAM generation
    [hvd-50-hd.kicad_sch]
2024-11-07 squishy: connectors: updated part metadata on hd-50-idc prior to CAM generation
    [hvd-50-idc.kicad_sch]
2024-11-07 squishy: connectors: updated part metadata on hd-68-hd prior to CAM generation
    [hvd-68-hd.kicad_sch]
2024-11-07 squishy: connectors: updated part metadata on hd-68-vhdci prior to CAM generation
    [hvd-68-vhdci.kicad_sch]
2024-11-07 squishy: connectors: updated part metadata on mse-50-ce prior to CAM generation
    [mse-50-ce.kicad_sch]
2024-11-07 squishy: connectors: updated part metadata on mse-50-hd prior to CAM generation
    [mse-50-hd.kicad_sch]
2024-11-07 squishy: connectors: updated part metadata on mse-50-idc prior to CAM generation
    [mse-50-idc.kicad_sch]
2024-11-07 squishy: connectors: updated part metadata on mse-68-hd prior to CAM generation
    [mse-68-hd.kicad_sch]
2024-11-07 squishy: connectors: updated part metadata on mse-68-vhdci prior to CAM generation
    [mse-68-vhdci.kicad_sch]
2024-11-07 squishy: connectors: fixed the board outline on hvd-50-ce due to some slightly off-grid arcs
    [hvd-50-ce.kicad_pcb]
2024-11-07 squishy: connectors: fixed the board outline on mse-50-ce due to some slightly off-grid arcs
    [mse-50-ce.kicad_pcb]
2024-11-07 panels: connectors: Added hvd-50-ce panel
2024-11-07 panels: connectors: Added mse-50-ce panel
2024-11-07 panels: connectors: Added hvd-50-hd panel
    [hvd-50-hd-panel.kicad_pcb]
2024-11-07 panels: connectors: Added mse-50-hd panel
    [mse-50-hd-panel.kicad_pcb]
2024-11-07 panels: connectors: Added hvd-50-idc panel
2024-11-07 panels: connectors: Added mse-50-idc panel
2024-11-07 panels: connectors: Added hvd-68-hd panel
2024-11-07 panels: connectors: Added mse-68-hd panel
2024-11-07 panels: connectors: Added hvd-68-vhdci panel
2024-11-07 panels: connectors: Added mse-68-vhdci panel
2024-11-07 releases: rev2-evt: connectors: Added hvd-50-ce CAM files
    [hvd-50-ce-B_Cu.gbl, hvd-50-ce-B_Fab.gbr, hvd-50-ce-B_Mask.gbs, hvd-50-ce-B_Paste.gbp, hvd-50-ce-B_Silkscreen.gbo, hvd-50-ce-Edge_Cuts.gm1, hvd-50-ce-F_Cu.gtl, hvd-50-ce-F_Fab.gbr]
2024-11-07 releases: rev2-evt: connectors: Added hvd-50-hd CAM files
    [hvd-50-hd-B_Cu.gbl, hvd-50-hd-B_Fab.gbr, hvd-50-hd-B_Mask.gbs, hvd-50-hd-B_Paste.gbp, hvd-50-hd-B_Silkscreen.gbo, hvd-50-hd-Edge_Cuts.gm1, hvd-50-hd-F_Cu.gtl, hvd-50-hd-F_Fab.gbr]
2024-11-07 releases: rev2-evt: connectors: Added hvd-50-idc CAM files
    [hvd-50-idc-B_Cu.gbl, hvd-50-idc-B_Fab.gbr, hvd-50-idc-B_Mask.gbs, hvd-50-idc-B_Paste.gbp, hvd-50-idc-B_Silkscreen.gbo, hvd-50-idc-Edge_Cuts.gm1, hvd-50-idc-F_Cu.gtl, hvd-50-idc-F_Fab.gbr]
2024-11-07 releases: rev2-evt: connectors: Added hvd-68-hd CAM files
    [hvd-68-hd-B_Cu.gbl, hvd-68-hd-B_Fab.gbr, hvd-68-hd-B_Mask.gbs, hvd-68-hd-B_Paste.gbp, hvd-68-hd-B_Silkscreen.gbo, hvd-68-hd-Edge_Cuts.gm1, hvd-68-hd-F_Cu.gtl, hvd-68-hd-F_Fab.gbr]
2024-11-07 releases: rev2-evt: connectors: Added hvd-68-vhdci CAM files
    [hvd-68-vhdci-B_Cu.gbl, hvd-68-vhdci-B_Fab.gbr, hvd-68-vhdci-B_Mask.gbs, hvd-68-vhdci-B_Paste.gbp, hvd-68-vhdci-B_Silkscreen.gbo, hvd-68-vhdci-Edge_Cuts.gm1, hvd-68-vhdci-F_Cu.gtl, hvd-68-vhdci-F_Fab.gbr]
2024-11-07 releases: rev2-evt: connectors: Added mse-50-ce CAM files
    [mse-50-ce-B_Cu.gbl, mse-50-ce-B_Fab.gbr, mse-50-ce-B_Mask.gbs, mse-50-ce-B_Paste.gbp, mse-50-ce-B_Silkscreen.gbo, mse-50-ce-Edge_Cuts.gm1, mse-50-ce-F_Cu.gtl, mse-50-ce-F_Fab.gbr]
2024-11-07 releases: rev2-evt: connectors: Added mse-50-hd CAM files
    [mse-50-hd-B_Cu.gbl, mse-50-hd-B_Fab.gbr, mse-50-hd-B_Mask.gbs, mse-50-hd-B_Paste.gbp, mse-50-hd-B_Silkscreen.gbo, mse-50-hd-Edge_Cuts.gm1, mse-50-hd-F_Cu.gtl, mse-50-hd-F_Fab.gbr]
2024-11-07 releases: rev2-evt: connectors: Added mse-50-idc CAM files
    [mse-50-idc-B_Cu.gbl, mse-50-idc-B_Fab.gbr, mse-50-idc-B_Mask.gbs, mse-50-idc-B_Paste.gbp, mse-50-idc-B_Silkscreen.gbo, mse-50-idc-Edge_Cuts.gm1, mse-50-idc-F_Cu.gtl, mse-50-idc-F_Fab.gbr]
2024-11-07 releases: rev2-evt: connectors: Added mse-68-hd CAM files
    [mse-68-hd-B_Cu.gbl, mse-68-hd-B_Fab.gbr, mse-68-hd-B_Mask.gbs, mse-68-hd-B_Paste.gbp, mse-68-hd-B_Silkscreen.gbo, mse-68-hd-Edge_Cuts.gm1, mse-68-hd-F_Cu.gtl, mse-68-hd-F_Fab.gbr]
2024-11-07 releases: rev2-evt: connectors: Added mse-68-vhdci CAM files
    [mse-68-vhdci-B_Cu.gbl, mse-68-vhdci-B_Fab.gbr, mse-68-vhdci-B_Mask.gbs, mse-68-vhdci-B_Paste.gbp, mse-68-vhdci-B_Silkscreen.gbo, mse-68-vhdci-Edge_Cuts.gm1, mse-68-vhdci-F_Cu.gtl, mse-68-vhdci-F_Fab.gbr]
2024-11-19 squishy: connectors: Fixed some clearence issues in the hvd-68-vhdci connector routing
    [hvd-68-vhdci.kicad_pcb]
2024-11-19 squishy: connectors: Fixed some clearence issues in the mse-68-vhdci connector routing
    [mse-68-vhdci.kicad_pcb]
2024-11-19 squishy: connectors: Fixed some further clearence issues in the hvd-68-vhdci connector routing
    [hvd-68-vhdci.kicad_pcb]
2024-11-19 squishy: connectors: Fixed some further clearence issues in the mse-68-vhdci connector routing
    [hvd-68-vhdci.kicad_pcb, mse-68-vhdci.kicad_pcb]
2024-12-31 releases: rev2-evt: connectors: Added some found errata, one can't be bodged but is non-functional, the other can but only by dead-bugging the flash
2025-02-11 squishy: phy: lvd: Started re-working the LVD PHY
    [squishy-lvd-phy-termination.kicad_sch, squishy-lvd-phy-transceivers.kicad_sch, squishy-phy-lvd.kicad_pcb, squishy-phy-lvd.kicad_sch]
2025-03-31 squishy: main: Upgraded to KiCad v9
    [squishy-main-power.kicad_sch, squishy-main-usbfe.kicad_sch, squishy-main.kicad_sch]
2025-03-31 squishy: phy: se: Upgraded to KiCad v9
    [squishy-phy-se.kicad_pcb, squishy-phy-se.kicad_sch]
2025-03-31 squishy: phy: hvd; Upgraded to KiCad v9
    [squishy-phy-hvd.kicad_pcb, squishy-phy-hvd.kicad_sch]
2025-03-31 squishy: phy: lvd-mse: Upgraded to KiCad v9
    [squishy-phy-lvd-mse.kicad_pcb, squishy-phy-lvd-mse.kicad_sch]
2025-03-31 squishy: phy: lvd: Upgraded to KiCad v9
    [squishy-lvd-phy-transceivers.kicad_sch, squishy-phy-lvd.kicad_pcb, squishy-phy-lvd.kicad_sch]
2025-03-31 squishy: connector: hvd-50-ce: Upgraded to KiCad v9
    [hvd-50-ce.kicad_pcb, hvd-50-ce.kicad_sch]
2025-03-31 squishy: connector: hvd-50-hd: Upgraded to KiCad v9
    [hvd-50-hd.kicad_pcb, hvd-50-hd.kicad_sch]
2025-03-31 squishy: connector: hvd-50-idc: Upgraded to KiCad v9
    [hvd-50-idc.kicad_pcb, hvd-50-idc.kicad_sch]
2025-03-31 squishy: connector: hvd-68-hd: Upgraded to KiCad v9
    [hvd-68-hd.kicad_pcb, hvd-68-hd.kicad_sch]
2025-03-31 squishy: connector: hvd-68-vhdci: Upgraded to KiCad v9
    [hvd-68-vhdci.kicad_pcb, hvd-68-vhdci.kicad_sch]
2025-03-31 squishy: connector: mse-50-ce: Upgraded to KiCad v9
    [mse-50-ce.kicad_pcb, mse-50-ce.kicad_sch]
2025-03-31 squishy: connector: mse-50-hd: Upgraded to KiCad v9
    [mse-50-hd.kicad_pcb, mse-50-hd.kicad_sch]
2025-03-31 squishy: connector: mse-50-idc: Upgraded to KiCad v9
    [mse-50-idc.kicad_pcb, mse-50-idc.kicad_sch]
2025-03-31 squishy: connector: mse-68-hd: Upgraded to KiCad v9
    [mse-68-hd.kicad_pcb, mse-68-hd.kicad_sch]
2025-03-31 squishy: connector: mse-68-vhdci: Upgraded to KiCad v9
    [mse-68-vhdci.kicad_pcb, mse-68-vhdci.kicad_sch]
